shimotoriharuki/2019_RobotLancer_kicad/General_purpose_lancer_board/PIC/pcb.png

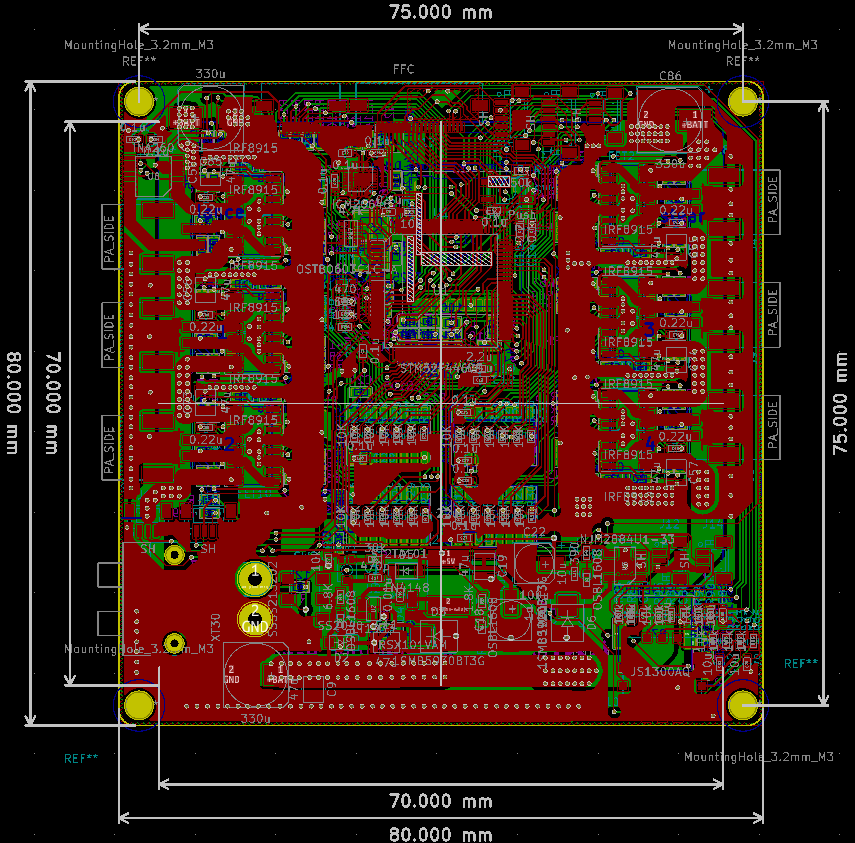
General_purpose_lancer_board/PIC/pcb.png
