shimotoriharuki/2019_RobotLancer_kicad/General_purpose_lancer_board_sub/PIC/top.png

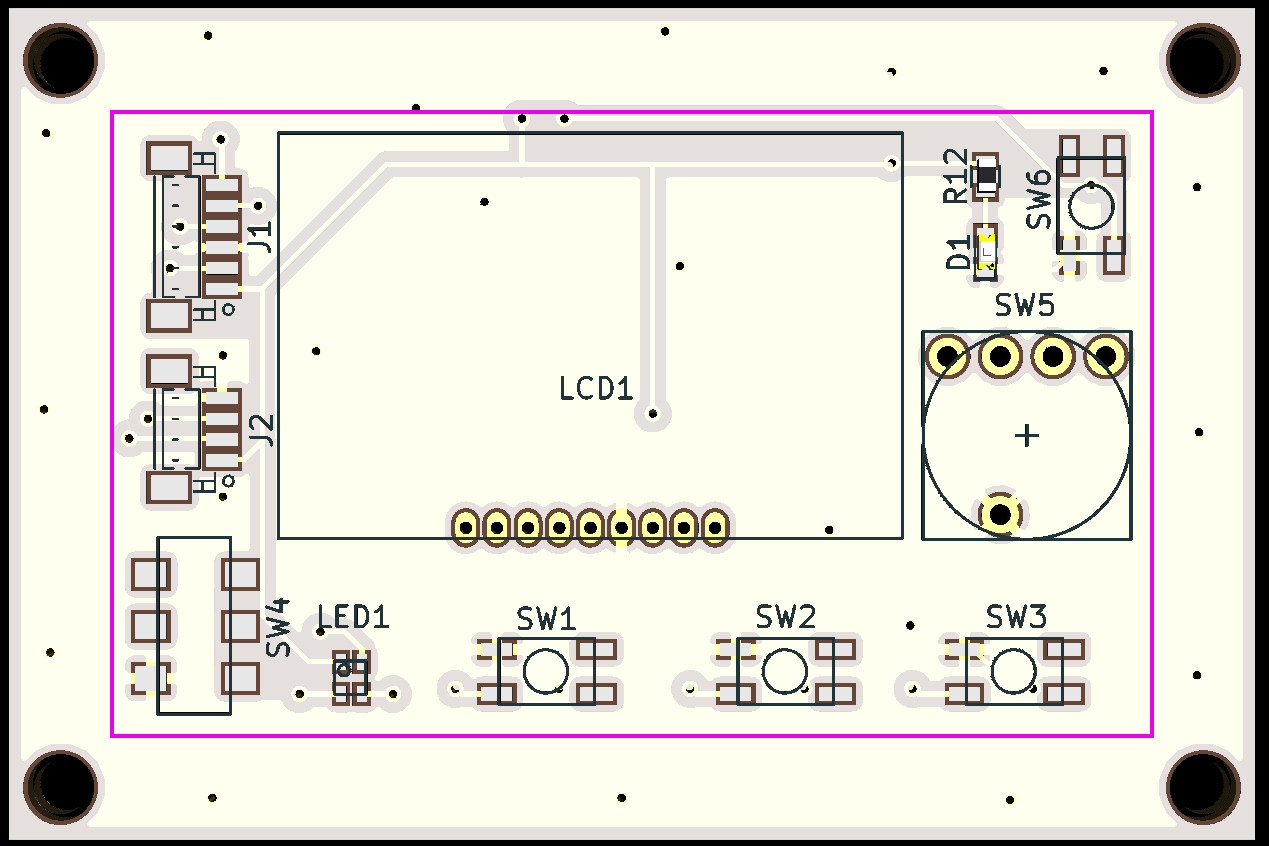
General_purpose_lancer_board_sub/PIC/top.png
