shimotoriharuki/2019_RobotLancer_kicad/General_purpose_lancer_sensor_board/PIC/top.png

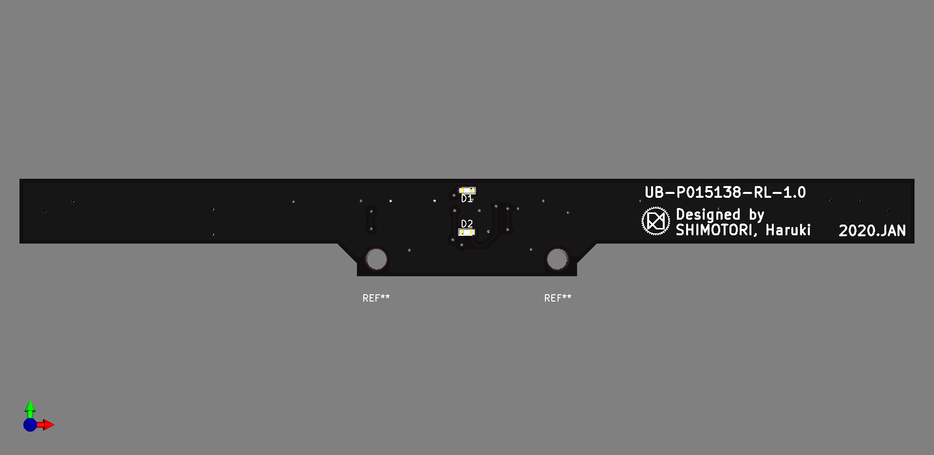
General_purpose_lancer_sensor_board/PIC/top.png
