shimotoriharuki/2019_RobotLancer_kicad/General_purpose_lancer_sensor_board/PIC/コメント 2020-01-31 151015.png

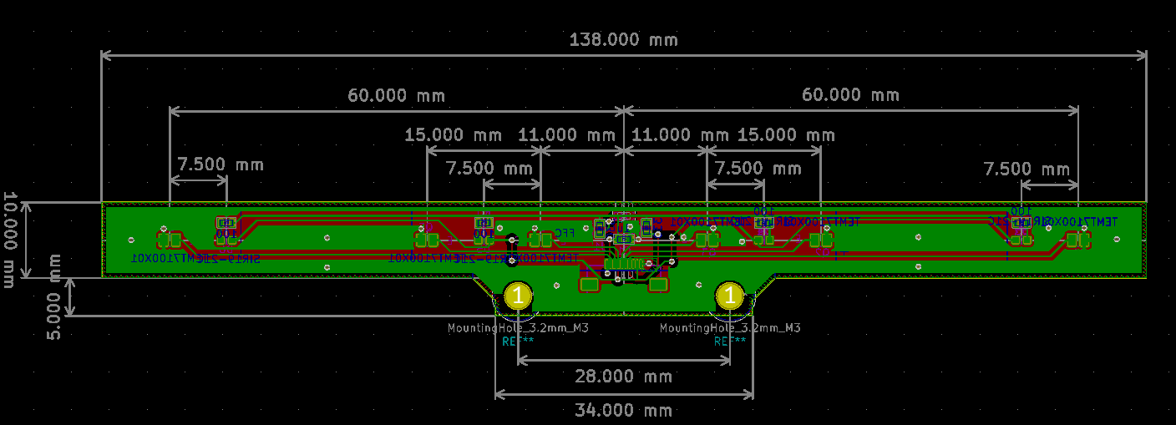
General_purpose_lancer_sensor_board/PIC/コメント 2020-01-31 151015.png
