shimotoriharuki/2019_RobotLancer_kicad/General_purpose_lancer_sensor_board/ref/コメント 2020-01-18 161346.png

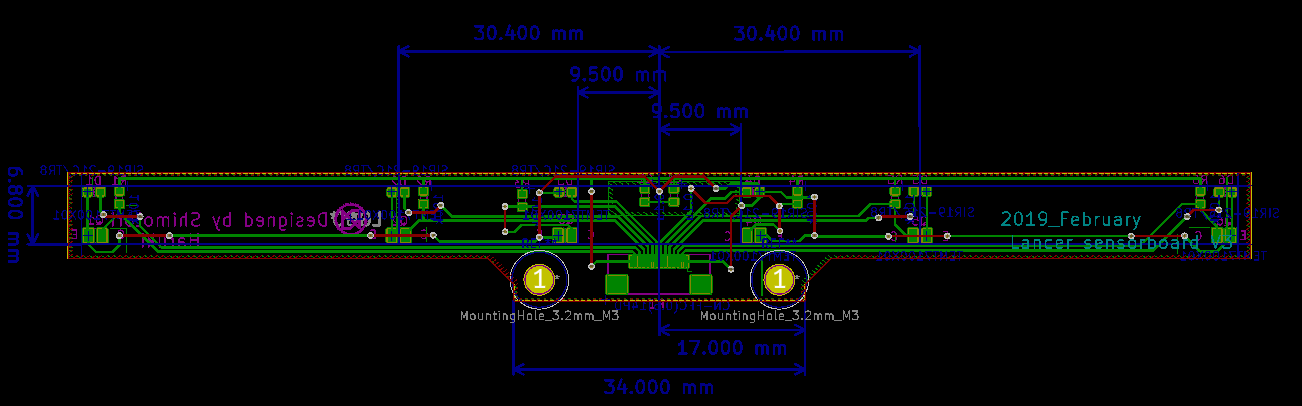
General_purpose_lancer_sensor_board/ref/コメント 2020-01-18 161346.png
