shimotoriharuki/2019_RobotLancer_kicad/General_purpose_lancer_board/General_purpose_lancer_board.xlsx

Library | Part | Footprint | Value | Number | Reference
Connector | Micro_SD_Card_Det_Hirose_DM3AT | Connectors_Card:Hirose_DM3AT-SF-PEJM5 | Micro_SD_Card_Det_Hirose_DM3AT | 1 | J13
Connector_Generic | Conn_01x02 | Footprint:SM02B-PASS | PA_SIDE | 6 | J9, J8, J5, J7, J4, J6
Connector_Generic | Conn_01x02 | Footprint:XT30PW-M | XT30 | 1 | J3
Connector_Generic | Conn_01x03 | Connectors_JST:JST_SH_BM03B-SRSS-TB_03x1.00mm_Straight | SH | 3 | J11, J12, J14
Connector_Generic | Conn_01x04 | Connectors_JST:JST_SH_BM04B-SRSS-TB_04x1.00mm_Straight | SH | 2 | J10, J2
Connector_Generic | Conn_01x05 | Connectors_JST:JST_SH_BM05B-SRSS-TB_05x1.00mm_Straight | SH | 1 | J15
Connector_Generic | Conn_01x06 | Connectors_JST:JST_SH_BM06B-SRSS-TB_06x1.00mm_Straight | SH | 1 | J1
Connector_Generic | Conn_01x10 | Footprint:Molex_FFC_10 | FFC | 1 | J16
Connector_Generic | Conn_01x22 | Footprint:Molex_FFC_22 | FFC | 1 | J17
Device | Buzzer | Buzzers_Beepers:Buzzer_Murata_PKMCS0909E4000-R1 | PKMCS0909E4000-R1 | 1 | BZ1
Device | C | Capacitors_SMD:C_0603 | 10u | 1 | C84
Device | C | Capacitors_SMD:C_1210 | 47u | 6 | C56, C73, C74, C58, C55, C57
Device | CP | Capacitors_SMD:CP_Elec_8x6.7 | 330u | 2 | C85, C86
Device | CP | Capacitors_SMD:C_1210 | 47u | 1 | C83
Device | CP_Small | Capacitors_SMD:CP_Elec_5x5.8 | 100u | 2 | C22, C18
Device | CP_Small | Capacitors_SMD:CP_Elec_8x6.7 | 330u | 1 | C8
Device | C_Small | Capacitors_SMD:C_0603 | 0.01u | 1 | C16
Device | C_Small | Capacitors_SMD:C_0603 | 0.1u | 34 | C1, C26, C30, C12, C15, C25, C29, C24, C28, C77, C3, C6, C2, C82, C76, C31, C5, C59, C81, C78, C64, C7, C13, C60, C80, C63, C32, C33, C4, C23, C79, C75, C27, C37
Device | C_Small | Capacitors_SMD:C_0603 | 0.22u | 18 | C69, C41, C50, C65, C49, C39, C46, C47, C40, C44, C66, C72, C43, C71, C51, C54, C53, C68
Device | C_Small | Capacitors_SMD:C_0603 | 0.47u | 6 | C38, C36, C62, C35, C61, C34
Device | C_Small | Capacitors_SMD:C_0603 | 10u | 7 | C52, C48, C70, C21, C67, C45, C42
Device | C_Small | Capacitors_SMD:C_0603 | 1u | 1 | C20
Device | C_Small | Capacitors_SMD:C_0603 | 2.2u | 2 | C10, C14
Device | C_Small | Capacitors_SMD:C_0603 | 470p | 1 | C17
Device | C_Small | Capacitors_SMD:C_1210 | 47u | 3 | C9, C19, C11
Device | D_Schottky_Small_ALT | Diodes_SMD:D_SOD-123 | 1N4148 | 1 | D5
Device | D_Schottky_Small_ALT | Diodes_SMD:D_SOD-123F | SS2040 | 1 | D2
Device | D_Schottky_Small_ALT | Footprint:TUMD2M | RSX101VAM | 1 | D4
Device | D_Zener_Small_ALT | Diodes_SMD:D_SMB | 1SMB5920BT3G | 1 | D6
Device | D_Zener_Small_ALT | Diodes_SMD:D_SMB | 1SMB5930BT3G | 1 | D3
Device | Ferrite_Bead_Small | Inductors_SMD:L_0603 | 120 | 6 | L8, L7, L6, L5, L4, L3
Device | Ferrite_Bead_Small | Inductors_SMD:L_0603 | 330 | 1 | L1
Device | LED_Small_ALT | LEDs:LED_0603 | OSBL1608 | 3 | D7, D8, D1
Device | L_Small | Footprint:SD25-220-R | 22u | 1 | SD25-220-R1
Device | Q_NMOS_GSD | TO_SOT_Packages_SMD:SOT-23 | BSS138 | 1 | Q3
Device | Q_NMOS_GSD | TO_SOT_Packages_SMD:SOT-23 | IRLML6344 | 1 | Q2
Device | R | Resistors_SMD:R_0603 | 0 | 1 | R97
Device | R | Resistors_SMD:R_0603 | 1.2k | 1 | R84
Device | R | Resistors_SMD:R_0603 | 10K | 42 | R28, R35, R36, R39, R47, R42, R67, R69, R71, R46, R70, R30, R26, R22, R18, R14, R66, R10, R38, R33, R29, R25, R34, R37, R40, R21, R17, R11, R15, R41, R23, R27, R31, R13, R48, R32, R12, R16, R20, R24, R68, R19
Device | R | Resistors_SMD:R_0603 | 10k | 14 | R87, R88, R93, R96, R92, R99, R98, R90, R95, R91, R89, R94, R3, R107
Device | R | Resistors_SMD:R_0603 | 12k | 1 | R2
Device | R | Resistors_SMD:R_0603 | 15K | 1 | R5
Device | R | Resistors_SMD:R_0603 | 1k | 1 | R108
Device | R | Resistors_SMD:R_0603 | 22k | 7 | R106, R105, R101, R103, R104, R102, R100
Device | R | Resistors_SMD:R_0603 | 4.7k | 2 | R83, R74
Device | R | Resistors_SMD:R_0603 | 45 | 2 | R111, R117
Device | R | Resistors_SMD:R_0603 | 470 | 1 | R86
Device | R | Resistors_SMD:R_0603 | 47k | 1 | R114
Device | R | Resistors_SMD:R_0603 | 50k | 1 | R1
Device | R | Resistors_SMD:R_0603 | 680 | 1 | R85
Device | R | Resistors_SMD:R_0603 | R | 6 | R110, R116, R115, R112, R113, R109
Device | R_POT | Footprint:ST2TA | ST2TA101 | 1 | RV1
Device | R_Pack04 | Resistors_SMD:R_Array_Convex_4x0603 | 10K | 6 | RN2, RN3, RN1, RN6, RN4, RN5
Device | R_Pack04 | Resistors_SMD:R_Array_Convex_4x0603 | 4.7k | 1 | RN7
Device | R_Small | Resistors_SMD:R_0603 | 1.8K | 1 | R8
Device | R_Small | Resistors_SMD:R_0603 | 10k | 1 | R7
Device | R_Small | Resistors_SMD:R_0603 | 30k | 1 | R6
Device | R_Small | Resistors_SMD:R_0603 | 390 | 1 | R9
Device | R_Small | Resistors_SMD:R_0603 | 5k | 6 | R44, R73, R45, R49, R72, R43
Device | R_Small | Resistors_SMD:R_0603 | 6.8K | 1 | R4
Device | R_Small | Resistors_SMD:R_0603 | 75 | 24 | R63, R64, R65, R56, R57, R75, R58, R59, R60, R50, R51, R52, R53, R61, R80, R81, R82, R76, R77, R78, R79, R54, R55, R62
Oscillator | ASE-xxxMHz | Crystals:Crystal_SMD_EuroQuartz_X22-4pin_2.5x2.0mm_HandSoldering | ECS-2520S | 1 | X1
Oscillator | ASE-xxxMHz | Crystals:Crystal_SMD_EuroQuartz_X22-4pin_2.5x2.0mm_HandSoldering | TC25L5I32K7680 | 1 | X2
Switch | SW_Push | Footprint:SKRPACE010 | SKRPACE010 | 1 | SW1
Switch | SW_SPDT | Footprint:SSSS213202 | SSSS213202 | 1 | SW2
shimoharu_library | A3921 | Housings_SSOP:TSSOP-28-1EP_4.4x9.7mm_Pitch0.65mm | A3921 | 6 | IC5, IC1, IC2, IC4, IC3, IC6
shimoharu_library | ICM20648 | Footprint:ICM20648 | ICM20648 | 1 | U9
shimoharu_library | INA260 | Housings_SSOP:TSSOP-16_4.4x5mm_Pitch0.65mm | INA260 | 1 | U8
shimoharu_library | IRF8915 | Footprint:IRF8915 | IRF8915 | 12 | FET9, FET2, FET5, FET1, FET8, FET7, FET12, FET4, FET3, FET11, FET10, FET6
shimoharu_library | JS1300AQ | Footprint:JS1300 | JS1300AQ | 1 | U10
shimoharu_library | LT1933 | TO_SOT_Packages_SMD:TSOT-23-6 | LT1933 | 1 | U2
shimoharu_library | NJM2884U1-33 | TO_SOT_Packages_SMD:SOT-89-5_Housing | NJM2884U1-33 | 1 | U3
shimoharu_library | OSTB0603C1C-A | Footprint:OSTB0603C1C-A | OSTB0603C1C-A | 1 | LED1
shimoharu_library | SI8660BA | Housings_SOIC:SOIC-16_3.9x9.9mm_Pitch1.27mm | SI8660BA | 4 | U4, U5, U6, U7
shimoharu_library | STM32F446VE | Housings_QFP:LQFP-100_14x14mm_Pitch0.5mm | STM32F446VE | 1 | U1
shimoharu_library | uPA2815T1S | Footprint:SO-8_PowerPAK_Vishay_Single | SI7141DP | 1 | FET13
