shimotoriharuki/2019_RobotLancer_kicad/General_purpose_lancer_board_sub/General_purpose_lancer_board_sub.xlsx

Library | Part | Footprint | Value | Number | Reference
Connector_Generic | Conn_01x04 | Connectors_JST:JST_SH_BM04B-SRSS-TB_04x1.00mm_Straight | SH | 1 | J2
Connector_Generic | Conn_01x06 | Connectors_JST:JST_SH_BM06B-SRSS-TB_06x1.00mm_Straight | SH | 1 | J1
Connector_Generic | Conn_01x22 | Footprint:Molex_FFC_22 | FFC | 1 | J3
Device | C | Capacitors_SMD:C_0603 | 0.1u | 1 | C8
Device | CP | Capacitors_SMD:CP_Elec_5x5.8 | 82u | 1 | C9
Device | C_Small | Capacitors_SMD:C_0603 | 0.1u | 5 | C3, C7, C4, C2, C1
Device | C_Small | Capacitors_SMD:C_0603 | 1u | 2 | C5, C6
Device | LED | LEDs:LED_0603 | OSBL1608C1A | 1 | D1
Device | R | Resistors_SMD:R_0603 | 1.2k | 1 | R7
Device | R | Resistors_SMD:R_0603 | 10k | 6 | R4, R3, R1, R5, R2, R6
Device | R | Resistors_SMD:R_0603 | 360 | 1 | R12
Device | R | Resistors_SMD:R_0603 | 4.7k | 2 | R11, R10
Device | R | Resistors_SMD:R_0603 | 470 | 1 | R9
Device | R | Resistors_SMD:R_0603 | 680 | 1 | R8
Switch | SW_Coded_SH-7050 | Footprint:FR01SC16P | FR01SC16P-S | 1 | SW5
Switch | SW_Push | Footprint:SKRPACE010 | SKRPACE010 | 4 | SW3, SW2, SW6, SW1
Switch | SW_SPDT | Footprint:SSSS213202 | SSSS213202 | 1 | SW4
lancer_subbord-rescue | AQM0802A | Footprint:AQM0802A | AQM0802A | 1 | LCD1
shimoharu_library | OSTB0603C1C-A | Footprint:OSTB0603C1C-A | OSTB0603C1C-A | 1 | LED1
