shimotoriharuki/2019_RobotLancer_kicad/General_purpose_lancer_sensor_board/General_purpose_lancer_sensor_board.xlsx

Library | Part | Footprint | Value | Number | Reference
Connector_Generic | Conn_01x10 | Footprint:Molex_FFC_10 | FFC | 1 | J1
Device | C | Capacitors_SMD:C_0603 | 1u | 1 | C1
Device | LED | Footprint:SIR19-21C | SIR19-21C | 4 | D4, D3, D5, D6
Device | LED | LEDs:LED_0603 | OSBL1608C1A | 2 | D1, D2
Device | Q_Photo_NPN | Footprint:TEMT7100X01 | TEMT7100X01 | 6 | Q4, Q2, Q1, Q6, Q5, Q3
Device | R | Resistors_SMD:R_0603 | 100 | 4 | R4, R3, R5, R6
Device | R | Resistors_SMD:R_0603 | 330 | 2 | R1, R2
