shimotoriharuki/2019_RobotLancer_kicad/DXF/main_board_edge_8080.dxf

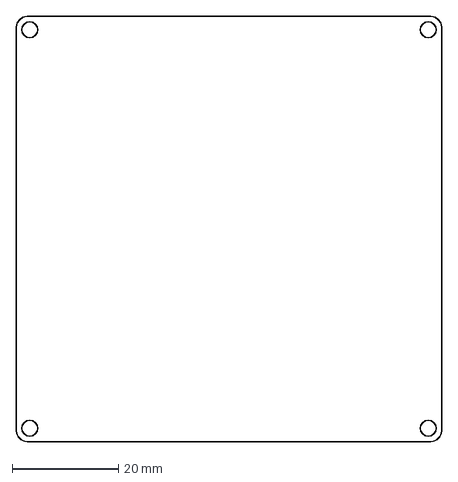
[picture p12: CAD file, 2021-03-22]
DXF/main_board_edge_8080.dxf
80.0 x 80.0 mm
