shimotoriharuki/2019_RobotLancer_kicad/DXF/main_board_edge.dxf

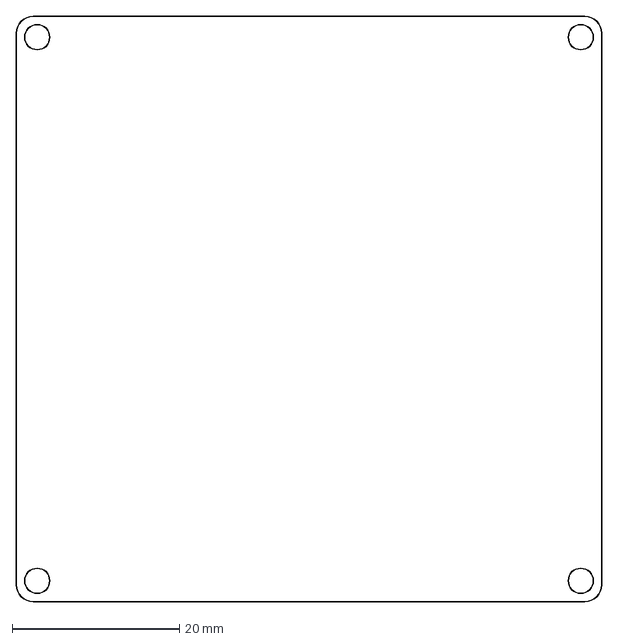
[picture p13: CAD file, 2021-03-22]
DXF/main_board_edge.dxf
70.0 x 70.0 mm
