shimotoriharuki/2019_RobotLancer_kicad/DXF/up plate.dxf

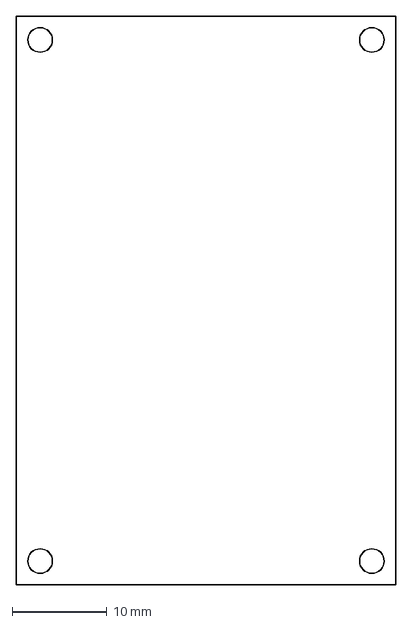
[picture p14: CAD file, 2021-03-22]
DXF/up plate.dxf
40.0 x 60.0 mm
