shimotoriharuki/2019_RobotLancer_kicad/General_purpose_lancer_board_sub/STEP/General_purpose_lancer_board_sub.step

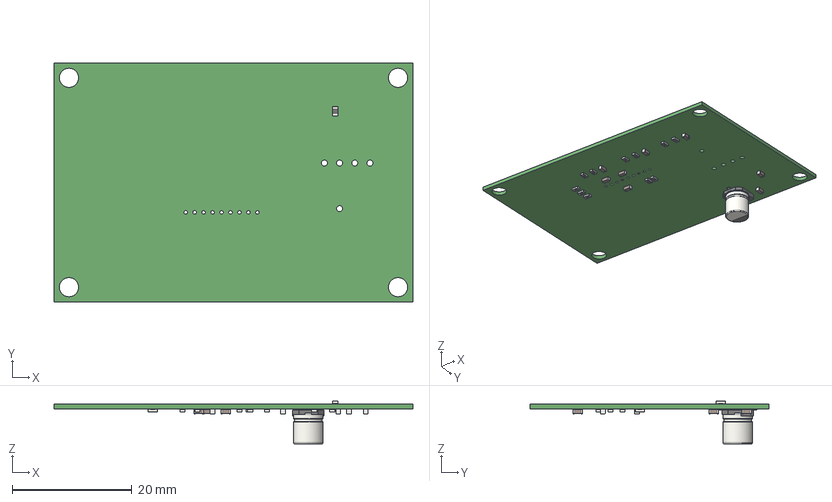
[picture p15: CAD file, 2021-03-22]
General_purpose_lancer_board_sub/STEP/General_purpose_lancer_board_sub.step
60.0 x 40.0 x 7.15 mm
LED_0603
