shimotoriharuki/2019_RobotLancer_kicad/General_purpose_lancer_sensor_board/STEP/General_purpose_lancer_sensor_board.step

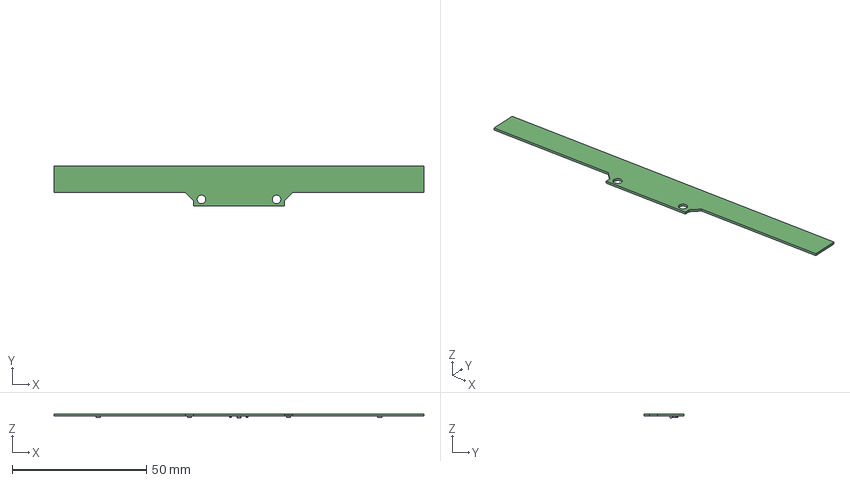
[picture p16: CAD file, 2021-03-22]
General_purpose_lancer_sensor_board/STEP/General_purpose_lancer_sensor_board.step
138.0 x 15.0 x 1.63 mm
LED_0603 x 2
