shimotoriharuki/2019_RobotLancer_kicad/(list of files, cad)

Other CAD files:
DXF/sensor.dxf
General_purpose_lancer_board/STEP/COMPOUND.ipt
General_purpose_lancer_board/STEP/CP_Elec_5x5.8.iam
General_purpose_lancer_board/STEP/CP_Elec_8x6.7.iam
General_purpose_lancer_board/STEP/C_0603.iam
General_purpose_lancer_board/STEP/C_1210.iam
General_purpose_lancer_board/STEP/D_SMB.iam
General_purpose_lancer_board/STEP/D_SOD-123.iam
General_purpose_lancer_board/STEP/D_SOD-123F.iam
General_purpose_lancer_board/STEP/General_purpose_lancer_board.iam
General_purpose_lancer_board/STEP/LQFP-100_14x14mm_Pitch0.5mm.iam
General_purpose_lancer_board/STEP/L_0603.iam
General_purpose_lancer_board/STEP/R_0603.iam
General_purpose_lancer_board/STEP/R_Array_Convex_4x0603.iam
General_purpose_lancer_board/STEP/SOIC-16_3.9x9.9mm_Pitch1.27mm.iam
General_purpose_lancer_board/STEP/SOLID.ipt
General_purpose_lancer_board/STEP/SOLID_1.ipt
General_purpose_lancer_board/STEP/SOLID_10.ipt
General_purpose_lancer_board/STEP/SOLID_11.ipt
General_purpose_lancer_board/STEP/SOLID_12.ipt
General_purpose_lancer_board/STEP/SOLID_13.ipt
General_purpose_lancer_board/STEP/SOLID_14.ipt
General_purpose_lancer_board/STEP/SOLID_2.ipt
General_purpose_lancer_board/STEP/SOLID_3.ipt
General_purpose_lancer_board/STEP/SOLID_4.ipt
General_purpose_lancer_board/STEP/SOLID_5.ipt
General_purpose_lancer_board/STEP/SOLID_6.ipt
General_purpose_lancer_board/STEP/SOLID_7.ipt
General_purpose_lancer_board/STEP/SOLID_8.ipt
General_purpose_lancer_board/STEP/SOLID_9.ipt
General_purpose_lancer_board/STEP/SOT-23.iam
General_purpose_lancer_board/STEP/TSSOP-16_4.4x5mm_Pitch0.65mm.iam
General_purpose_lancer_board/STEP/TSSOP-28_4.4x9.7mm_Pitch0.65mm.iam
General_purpose_lancer_board_sub/STEP/COMPOUND.ipt
General_purpose_lancer_board_sub/STEP/CP_Elec_5x5.8.iam
General_purpose_lancer_board_sub/STEP/C_0603.iam
General_purpose_lancer_board_sub/STEP/General_purpose_lancer_board_sub.iam
General_purpose_lancer_board_sub/STEP/R_0603.iam
General_purpose_lancer_board_sub/STEP/SOLID.ipt
General_purpose_lancer_board_sub/STEP/SOLID_1.ipt
General_purpose_lancer_board_sub/STEP/SOLID_2.ipt
