shimotoriharuki/2019_RobotLancer_kicad/General_purpose_lancer_board/PDF/General_purpose_lancer_board.pdf

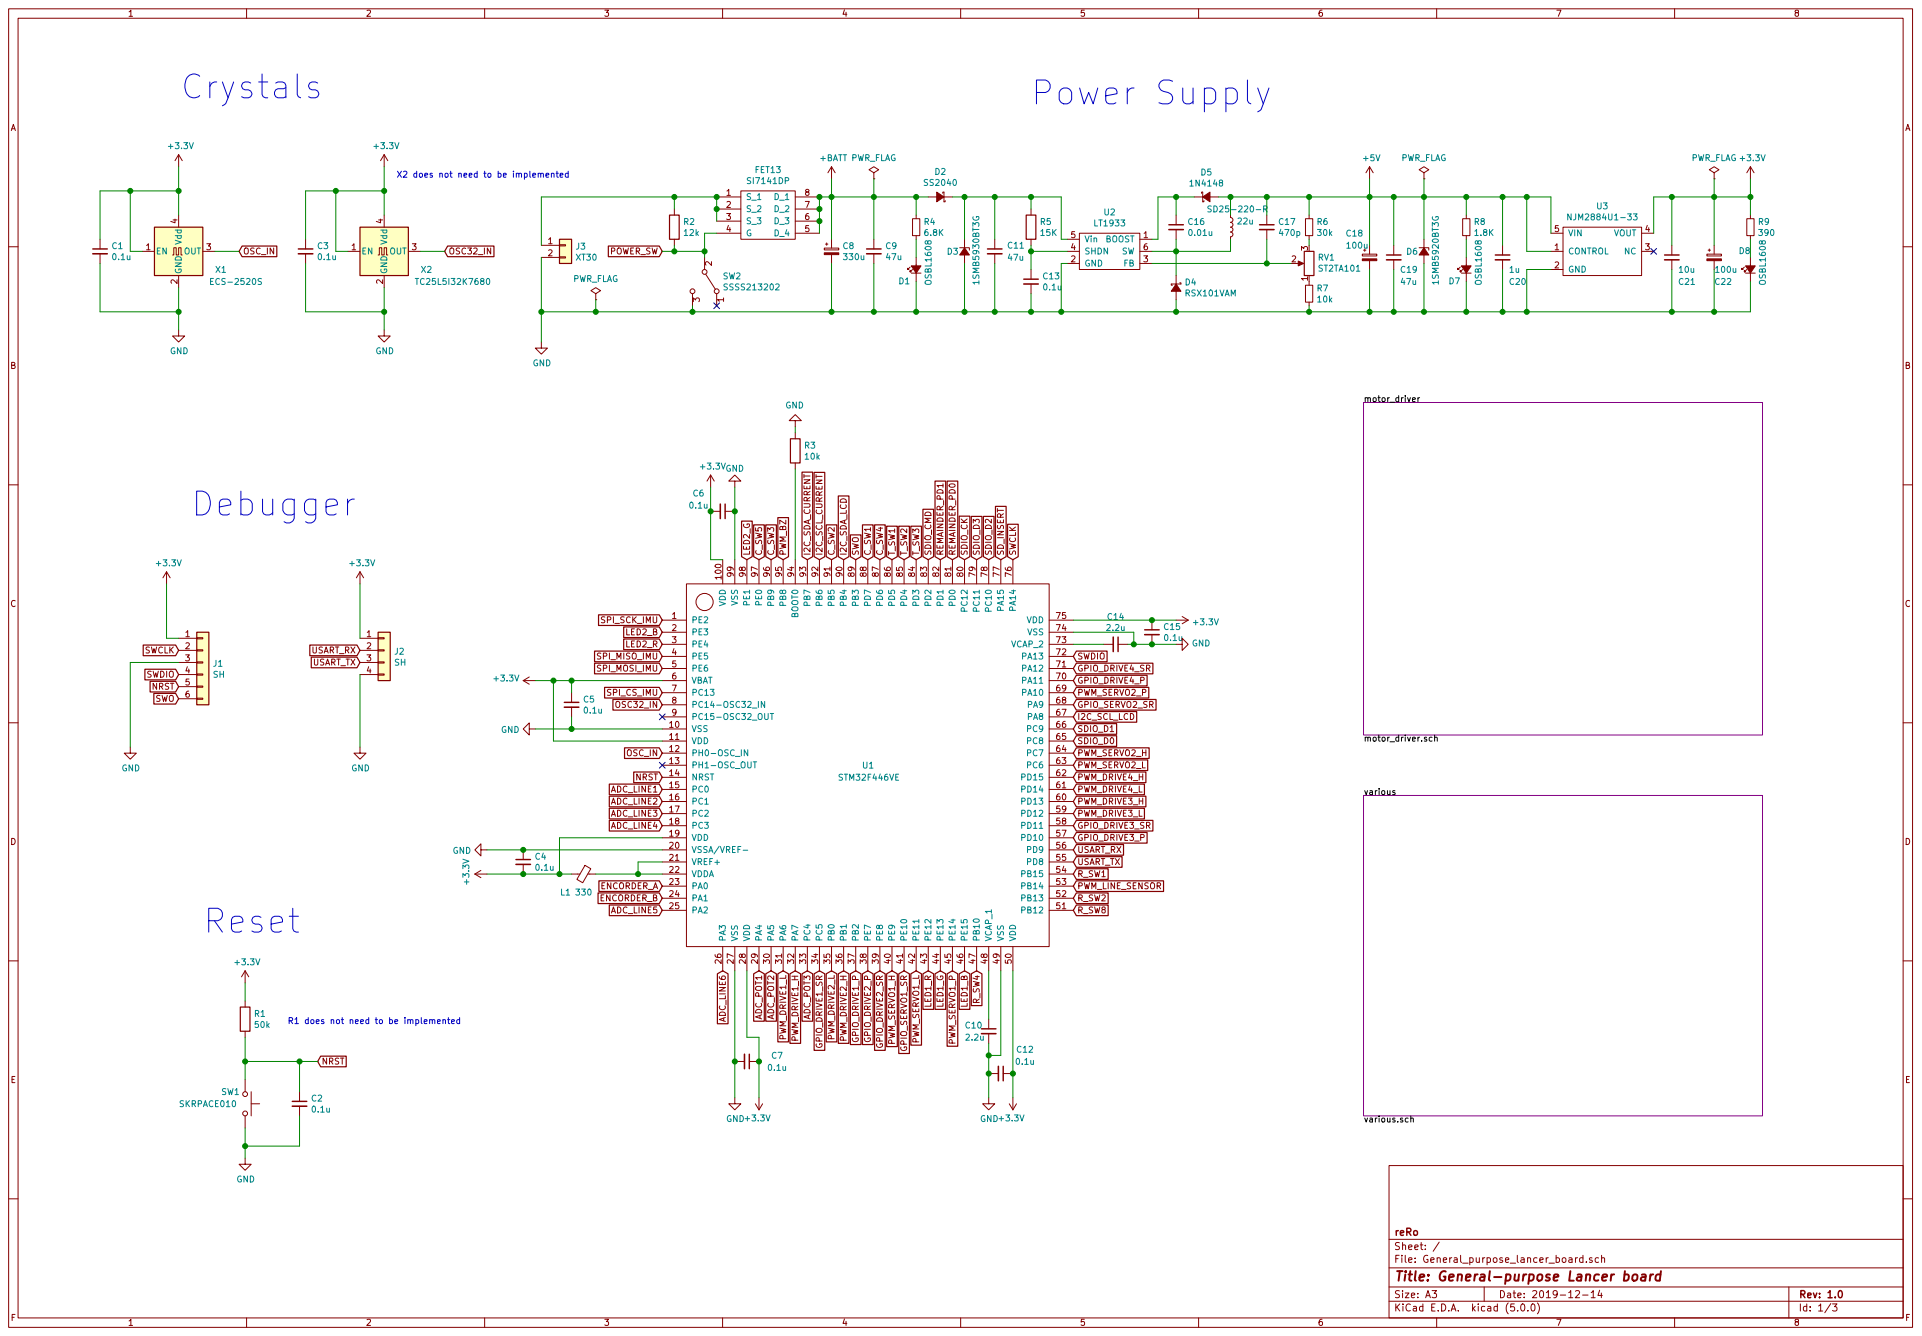
[picture p17: page 1]

X2 does not need to be implemented

R1 does not need to be implemented

File: General_purpose_lancer_board.sch Sheet: / reRo

Id: 1/3 Title: General-purpose Lancer board

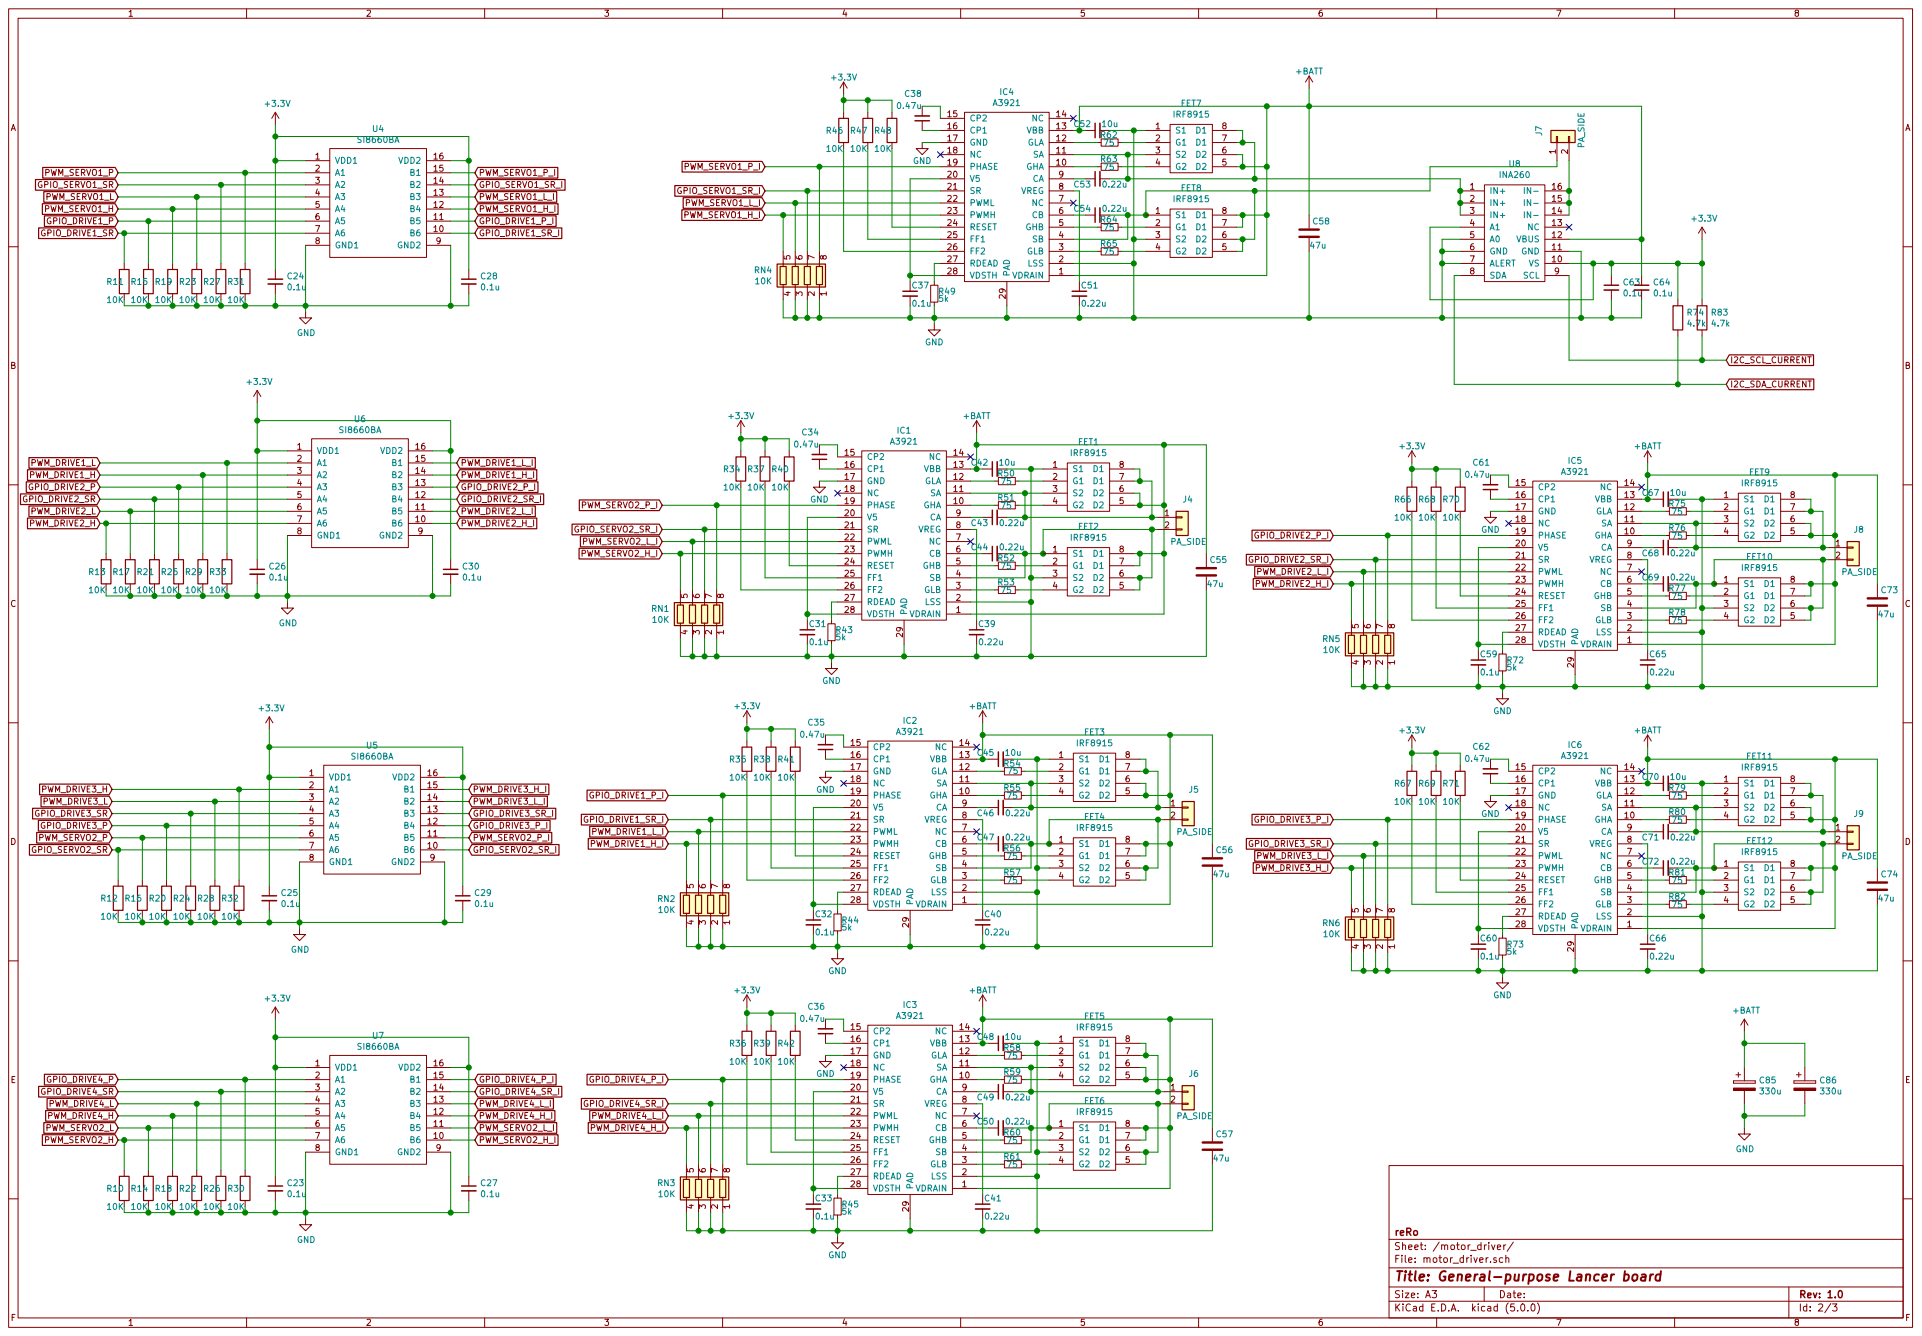
[picture p18: page 2]

File: motor_driver.sch
Id: 2/3 Title: General-purpose Lancer board

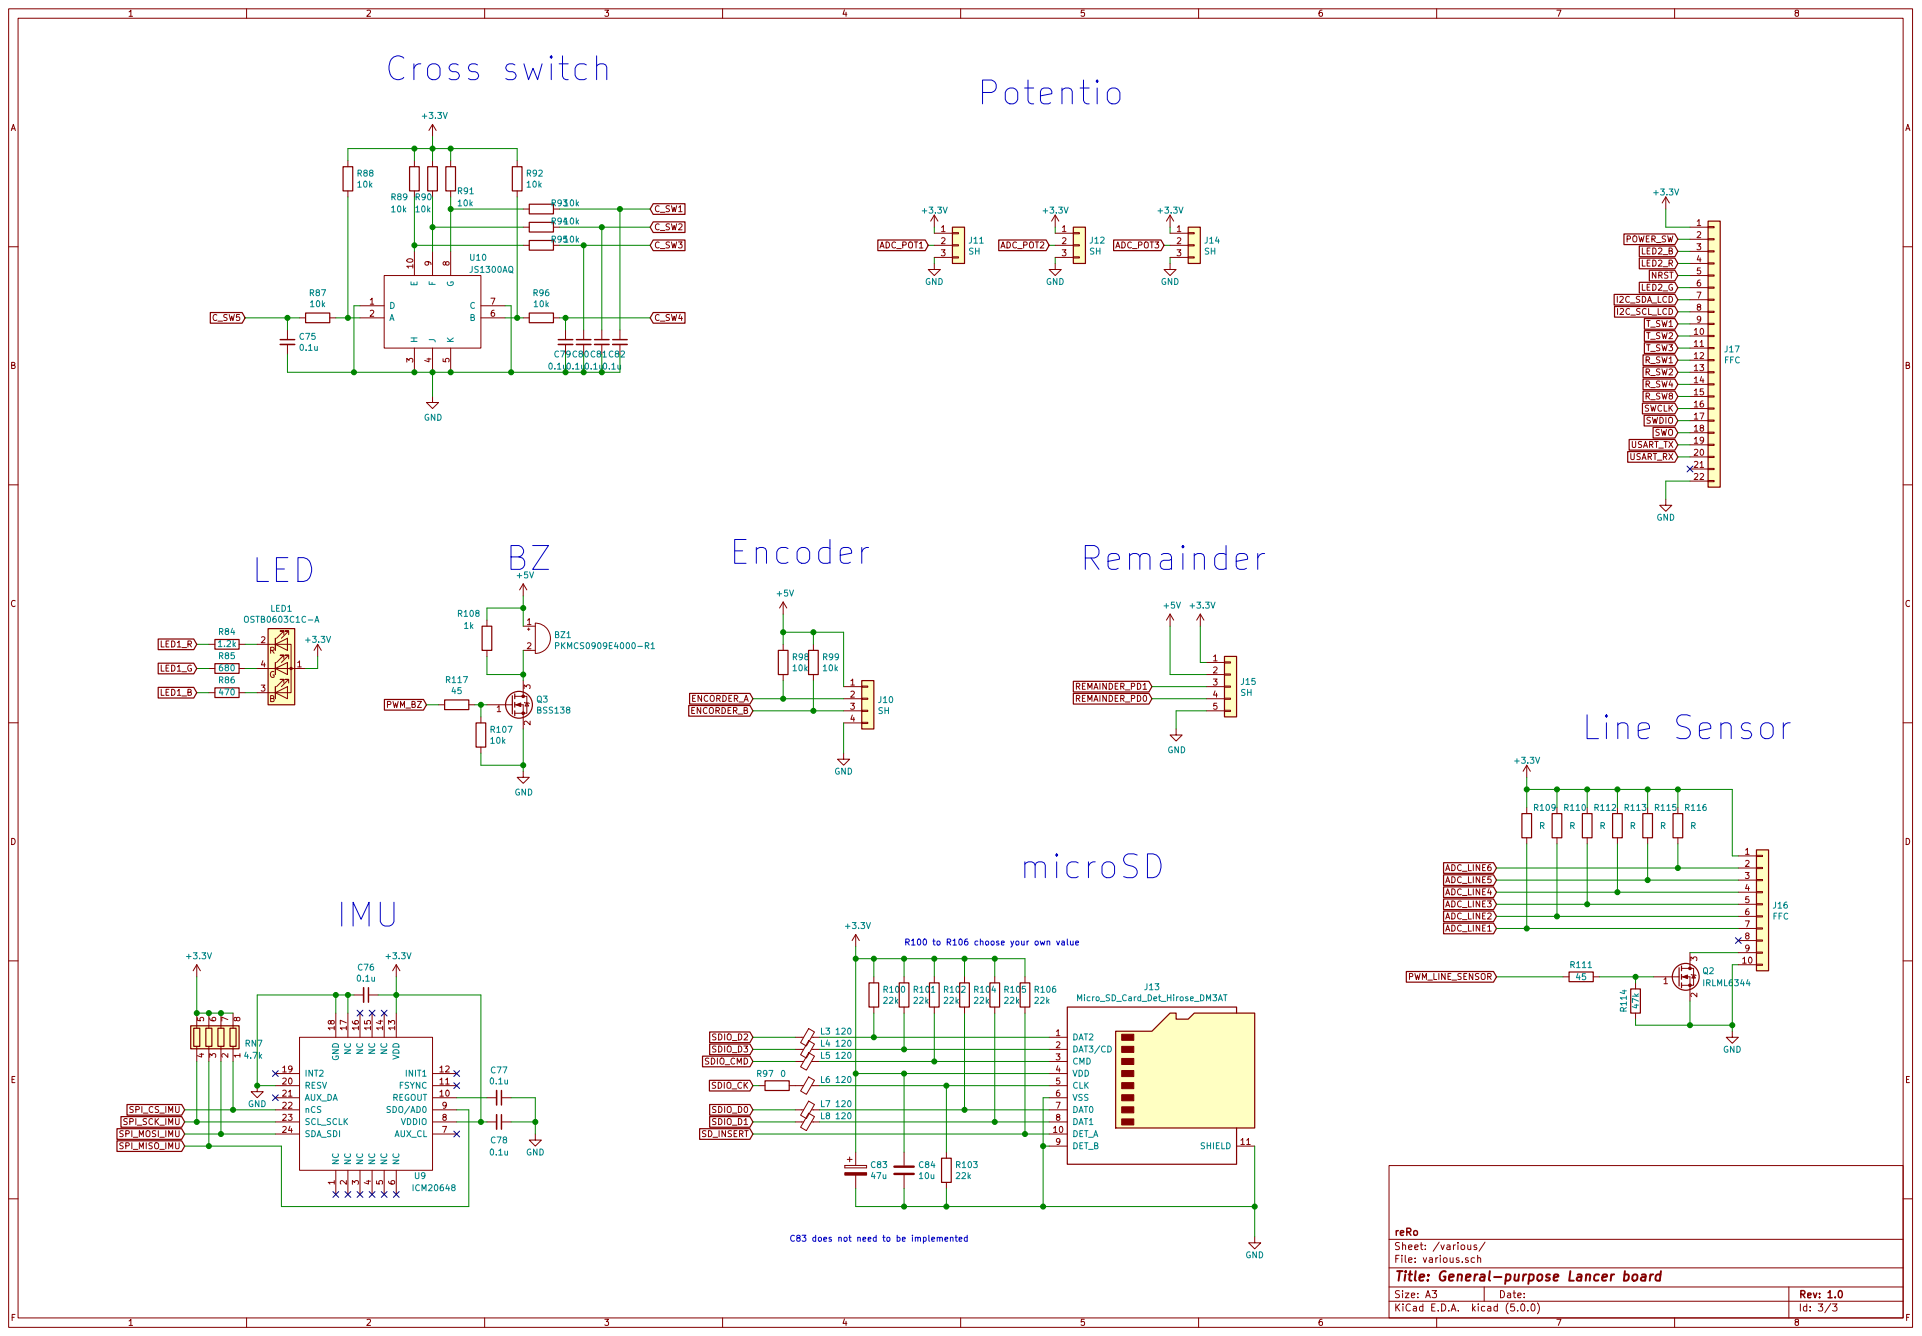
[picture p19: page 3]

File: various.sch Sheet: /various/ reRo GND microSD

R100 to R106 choose your own value

C83 does not need to be implemented

Id: 3/3 Title: General-purpose Lancer board
