shimotoriharuki/2019_RobotLancer_kicad/General_purpose_lancer_board_sub/PDF/General_purpose_lancer_board_sub.pdf

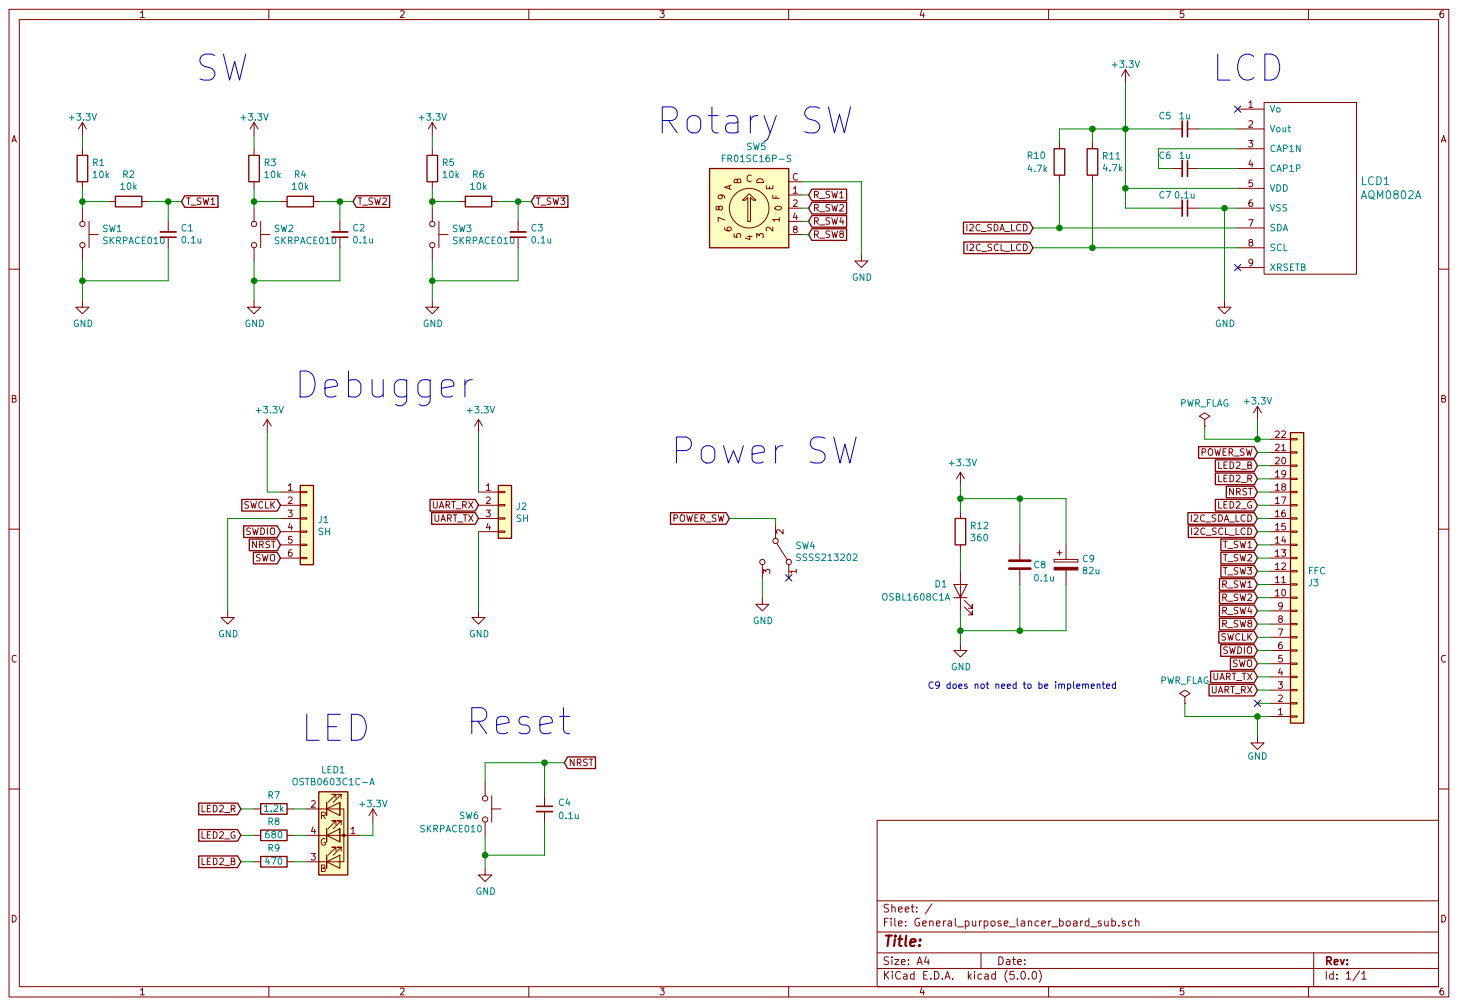
[picture p20: page 1]

C9 does not need to be implemented
