shimotoriharuki/2019_RobotLancer_kicad/General_purpose_lancer_sensor_board/PDF/General_purpose_lancer_sensor_board.pdf

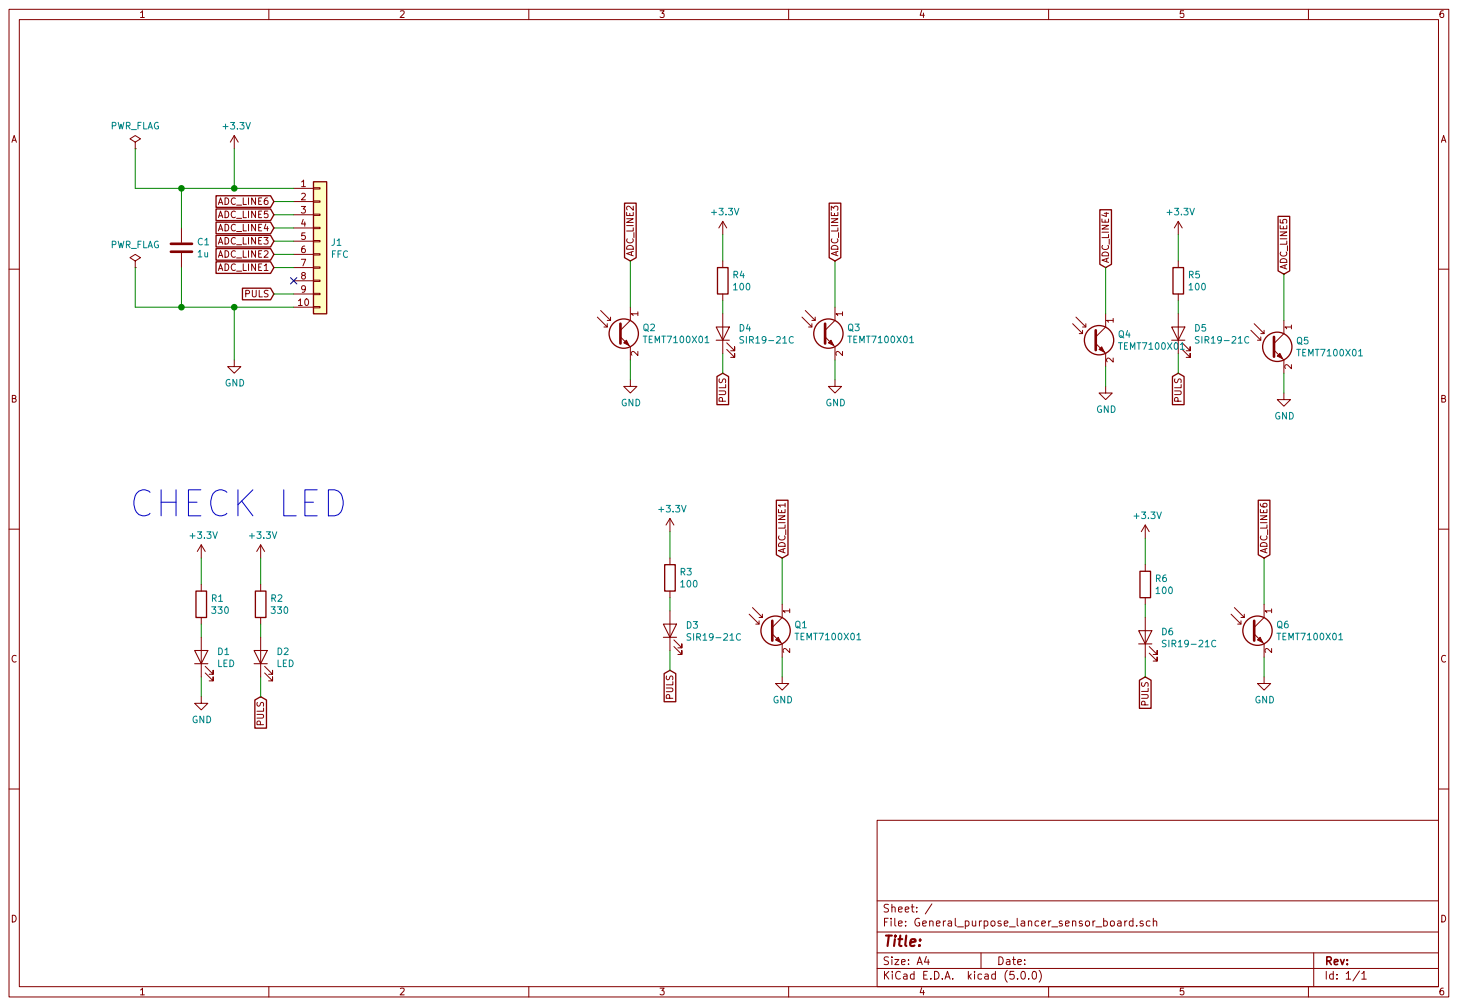
[picture p21: page 1]
