shimotoriharuki/2019_RobotLancer_kicad/General_purpose_lancer_sensor_board/General_purpose_lancer_sensor_board/PDF/General_purpose_lancer_sensor_board.pdf

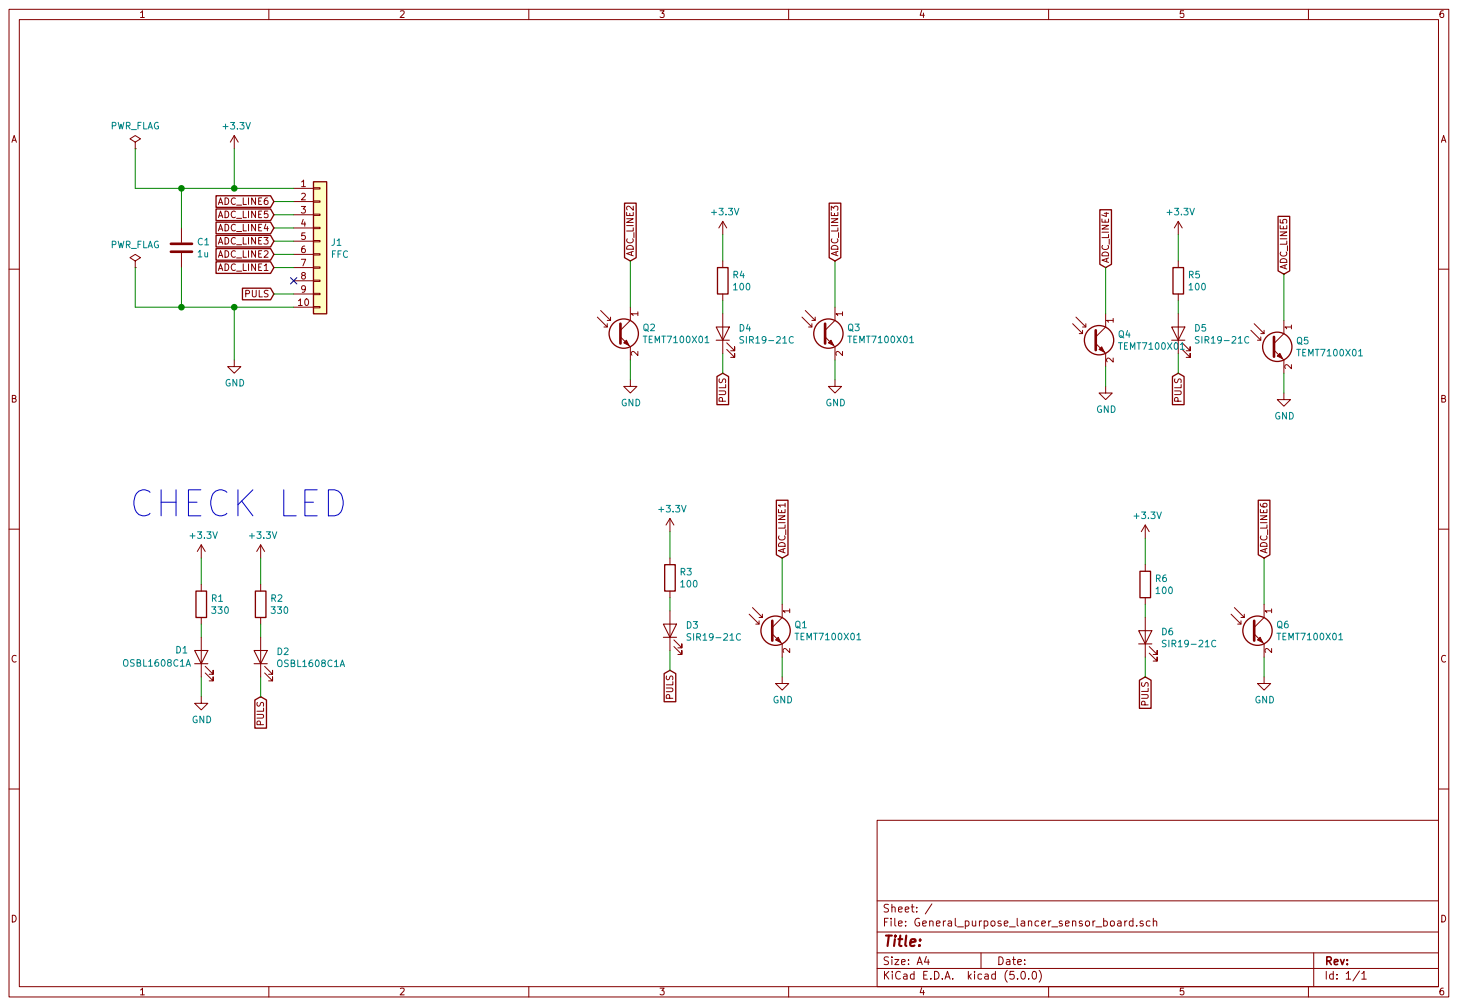
[picture p22: page 1]
