shimotoriharuki/2019_RobotLancer_kicad/General_purpose_lancer_board_sub/General_purpose_lancer_board_sub.kicad_pcb

## KiCad design General_purpose_lancer_board_sub/General_purpose_lancer_board_sub.kicad_pcb (2021-03-22)

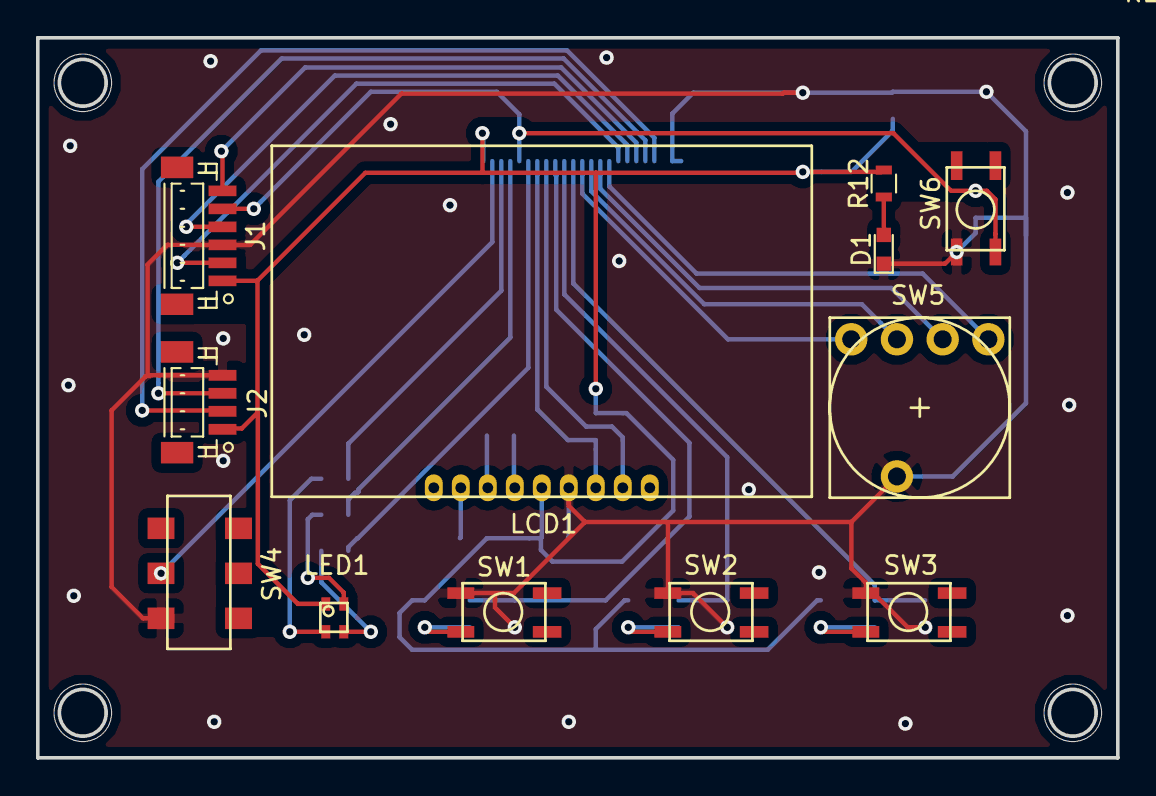
[picture p23: board General_purpose_lancer_board_sub.kicad_pcb from above]

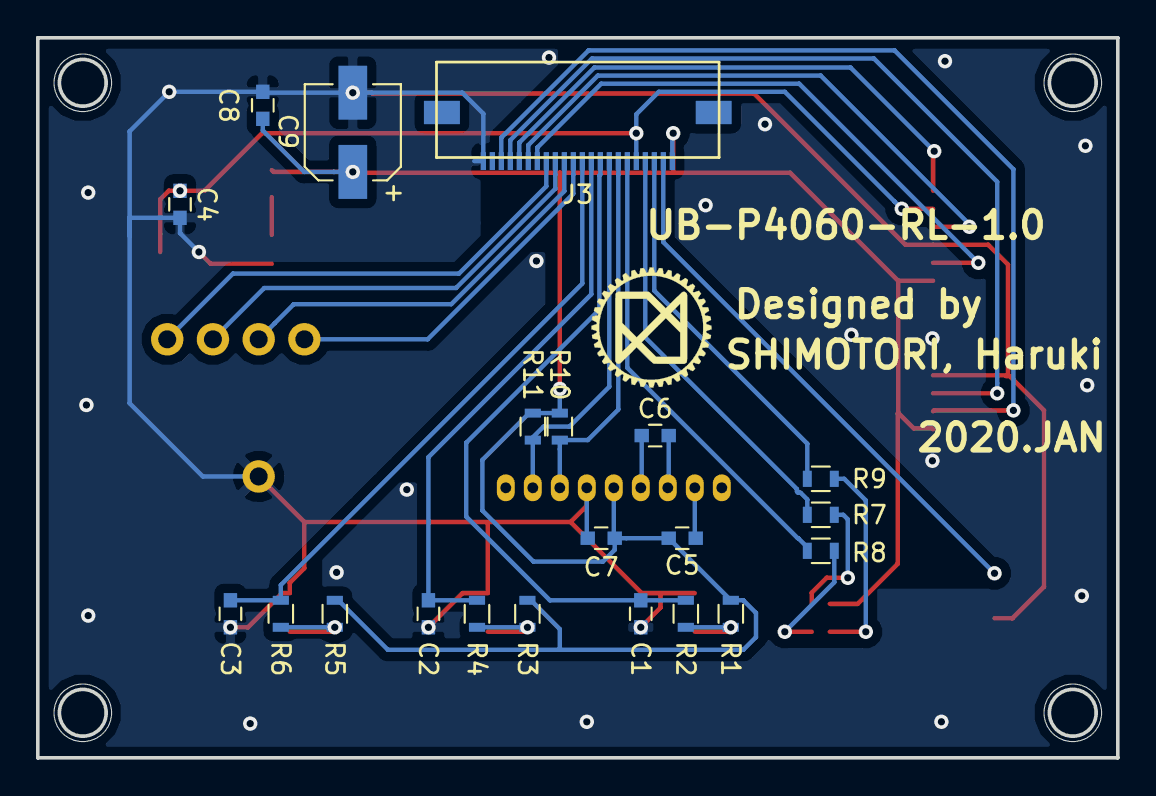
[picture p24: board General_purpose_lancer_board_sub.kicad_pcb from below]

Board: 2 copper layers, 60.0 x 40.0 mm, 33 parts (21 on the bottom side), 31 nets.

Parts:
C1, C2, C3, C4, C7: 0.1u; C_0603
C5, C6: 1u; C_0603
C8: 0.1; C_0603
C9: 82u; CP_Elec_5x5.8
D1: LED; LED_0603
J1: SH; JST_SH_BM06B-SRSS-TB_06x1.00mm_Straight
J2: SH; JST_SH_BM04B-SRSS-TB_04x1.00mm_Straight
J3: FFC; Molex_FFC_22
LCD1: AQM0802A
LED1: OSTB0603C1C-A
R1, R2, R3, R4, R5, R6: 10k; R_0603
R7: 1.2k; R_0603
R8: 680; R_0603
R9: 470; R_0603
R10, R11: 4.7k; R_0603
R12: 360; R_0603
SW1, SW2, SW3, SW6: SKRPACE010
SW4: SSSS213202
SW5: FR01SC16P-S; FR01SC16P

Connections:
+3V3: C5.2, C7.2, C8.1, C9.1, J1.1, J2.1, J3.22, LCD1.5, LED1.1, R1.1, R3.1, R5.1, R10.1, R11.1, R12.1
GND: C1.1, C2.1, C3.1, C4.2, C7.1, C8.2, C9.2, D1.1, J1.3, J2.4, J3.1, LCD1.6, SW1.2, SW2.2, SW3.2, SW4.3, SW5.C, SW6.2
I2C_SCL_LCD: J3.15, LCD1.8, R11.2
I2C_SDA_LCD: J3.16, LCD1.7, R10.2
LED2_B: J3.20, R9.1
LED2_G: J3.17, R8.1
LED2_R: J3.19, R7.1
NRST: C4.1, J1.5, J3.18, SW6.1
unnamed: C5.1, LCD1.2
unnamed: C6.1, LCD1.4
unnamed: C6.2, LCD1.3
unnamed: D1.2, R12.2
unnamed: LED1.2, R7.2
unnamed: LED1.3, R9.2
unnamed: LED1.4, R8.2
unnamed: R1.2, R2.2, SW1.1
unnamed: R3.2, R4.2, SW2.1
unnamed: R5.2, R6.2, SW3.1
POWER_SW: J3.21, SW4.2
R_SW1: J3.11, SW5.1
R_SW2: J3.10, SW5.2
R_SW4: J3.9, SW5.4
R_SW8: J3.8, SW5.8
SWCLK: J1.2, J3.7
SWDIO: J1.4, J3.6
SWO: J1.6, J3.5
T_SW1: C1.2, J3.14, R2.1
T_SW2: C2.2, J3.13, R4.1
T_SW3: C3.2, J3.12, R6.1
UART_RX: J2.2, J3.3
UART_TX: J2.3, J3.4
