shimotoriharuki/2019_RobotLancer_kicad/General_purpose_lancer_board/General_purpose_lancer_board.kicad_pcb

## KiCad design General_purpose_lancer_board/General_purpose_lancer_board.kicad_pcb (2021-03-22)

Schematic: General_purpose_lancer_board.sch, General-purpose Lancer board

Parts:
C1, C2, C3, C4, C5, C6, C7, C12, C13, C15: 0.1u; C_0603
C8: 330u; CP_Elec_8x6.7
C9, C11, C19: 47u; C_1210
C10, C14: 2.2u; C_0603
C16: 0.01u; C_0603
C17: 470p; C_0603
C18, C22: 100u; CP_Elec_5x5.8
C20: 1u; C_0603
C21: 10u; C_0603
D1, D7, D8: OSBL1608; LED_0603
D2: SS2040; D_SOD-123F
D3: 1SMB5930BT3G; D_SMB
D4: RSX101VAM; TUMD2M
D5: 1N4148; D_SOD-123
D6: 1SMB5920BT3G; D_SMB
FET13: SI7141DP; SO-8_PowerPAK_Vishay_Single
J1: SH; JST_SH_BM06B-SRSS-TB_06x1.00mm_Straight
J2: SH; JST_SH_BM04B-SRSS-TB_04x1.00mm_Straight
J3: XT30; XT30PW-M
L1: 330; L_0603
R1: 50k; R_0603
R2: 12k; R_0603
R3, R7: 10k; R_0603
R4: 6.8K; R_0603
R5: 15K; R_0603
R6: 30k; R_0603
R8: 1.8K; R_0603
R9: 390; R_0603
RV1: ST2TA101; ST2TA
SD25-220-R1: 22u; SD25-220-R
SW1: SKRPACE010
SW2: SSSS213202
U1: STM32F446VE; LQFP-100_14x14mm_Pitch0.5mm
U2: LT1933; TSOT-23-6
U3: NJM2884U1-33; SOT-89-5_Housing
X1: ECS-2520S; Crystal_SMD_EuroQuartz_X22-4pin_2.5x2.0mm_HandSoldering
X2: TC25L5I32K7680; Crystal_SMD_EuroQuartz_X22-4pin_2.5x2.0mm_HandSoldering

Connections:
+3V3: C1.1, C3.1, C4.2, C5.1, C6.2, C7.1, C12.1, C15.1, C21.1, C22.1, J1.1, J2.1, L1.2, R1.1, R9.1, U1.6, U1.11, U1.19, U1.28, U1.50, U1.75, U1.100, U3.4, X1.1, X1.4, X2.1, X2.4; also elsewhere on the board
+5V: C17.1, C18.1, C19.1, C20.1, D5.2, D6.1, R6.1, R8.1, U3.1, U3.5; also elsewhere on the board
+BATT: C8.1, C9.1, D2.2, FET13.5, FET13.6, FET13.7, FET13.8, R4.1; also elsewhere on the board
ADC_LINE1: U1.15; also elsewhere on the board
ADC_LINE2: U1.16; also elsewhere on the board
ADC_LINE3: U1.17; also elsewhere on the board
ADC_LINE4: U1.18; also elsewhere on the board
ADC_LINE5: U1.25; also elsewhere on the board
ADC_LINE6: U1.26; also elsewhere on the board
ADC_POT1: U1.29; also elsewhere on the board
ADC_POT2: U1.30; also elsewhere on the board
ADC_POT3: U1.33; also elsewhere on the board
C_SW1: U1.88; also elsewhere on the board
C_SW2: U1.91; also elsewhere on the board
C_SW3: U1.96; also elsewhere on the board
C_SW4: U1.87; also elsewhere on the board
C_SW5: U1.97; also elsewhere on the board
ENCORDER_A: U1.23; also elsewhere on the board
ENCORDER_B: U1.24; also elsewhere on the board
GND: C1.2, C2.2, C3.2, C4.1, C5.2, C6.1, C7.2, C8.2, C9.2, C10.2, C11.2, C12.2, C13.2, C14.1, C15.2, C18.2, C19.2, C20.2, C21.2, C22.2, D1.1, D3.2, D4.2, D6.2, D7.1, D8.1, J1.3, J2.4, J3.2, R3.1, R7.2, SW1.2, SW2.3, U1.10, U1.20, U1.27, U1.49, U1.74, U1.99, U2.2, U3.2, X1.2, X2.2; also elsewhere on the board
GPIO_DRIVE1_P: U1.37; also elsewhere on the board
GPIO_DRIVE1_SR: U1.34; also elsewhere on the board
GPIO_DRIVE2_P: U1.38; also elsewhere on the board
GPIO_DRIVE2_SR: U1.39; also elsewhere on the board
GPIO_DRIVE3_P: U1.57; also elsewhere on the board
GPIO_DRIVE3_SR: U1.58; also elsewhere on the board
GPIO_DRIVE4_P: U1.70; also elsewhere on the board
GPIO_DRIVE4_SR: U1.71; also elsewhere on the board
GPIO_SERVO1_SR: U1.41; also elsewhere on the board
GPIO_SERVO2_SR: U1.68; also elsewhere on the board
I2C_SCL_CURRENT: U1.92; also elsewhere on the board
I2C_SCL_LCD: U1.67; also elsewhere on the board
I2C_SDA_CURRENT: U1.93; also elsewhere on the board
I2C_SDA_LCD: U1.90; also elsewhere on the board
LED1_B: U1.46; also elsewhere on the board
LED1_G: U1.44; also elsewhere on the board
LED1_R: U1.43; also elsewhere on the board
LED2_B: U1.2; also elsewhere on the board
LED2_G: U1.98; also elsewhere on the board
LED2_R: U1.3; also elsewhere on the board
NRST: C2.1, J1.5, R1.2, SW1.1, U1.14; also elsewhere on the board
unnamed: C10.1, U1.48
unnamed: C11.1, D2.1, D3.1, R5.1, U2.5
unnamed: C13.1, R5.2, U2.4
unnamed: C14.2, U1.73
unnamed: C16.1, D5.1, U2.1
unnamed 57: C16.2, D4.1, U2.6; also elsewhere on the board
unnamed: C17.2, RV1.2, U2.3
unnamed: D1.2, R4.2
unnamed: D7.2, R8.2
unnamed: D8.2, R9.2
unnamed: FET13.1, FET13.2, FET13.3, J3.1, R2.1
unnamed: L1.1, U1.21, U1.22
unnamed: R3.2, U1.94
unnamed: R6.2, RV1.3
unnamed: R7.1, RV1.1
OSC32_IN: U1.8, X2.3
OSC_IN: U1.12, X1.3
POWER_SW: FET13.4, R2.2, SW2.2; also elsewhere on the board
PWM_BZ: U1.95; also elsewhere on the board
PWM_DRIVE1_H: U1.32; also elsewhere on the board
PWM_DRIVE1_L: U1.31; also elsewhere on the board
PWM_DRIVE2_H: U1.36; also elsewhere on the board
PWM_DRIVE2_L: U1.35; also elsewhere on the board
PWM_DRIVE3_H: U1.60; also elsewhere on the board
PWM_DRIVE3_L: U1.59; also elsewhere on the board
PWM_DRIVE4_H: U1.62; also elsewhere on the board
PWM_DRIVE4_L: U1.61; also elsewhere on the board
PWM_LINE_SENSOR: U1.53; also elsewhere on the board
PWM_SERVO1_H: U1.40; also elsewhere on the board
PWM_SERVO1_L: U1.42; also elsewhere on the board
PWM_SERVO1_P: U1.45; also elsewhere on the board
PWM_SERVO2_H: U1.64; also elsewhere on the board
PWM_SERVO2_L: U1.63; also elsewhere on the board
PWM_SERVO2_P: U1.69; also elsewhere on the board
REMAINDER_PD0: U1.81; also elsewhere on the board
REMAINDER_PD1: U1.82; also elsewhere on the board
R_SW1: U1.54; also elsewhere on the board
R_SW2: U1.52; also elsewhere on the board
R_SW4: U1.47; also elsewhere on the board
R_SW8: U1.51; also elsewhere on the board
SDIO_CK: U1.80; also elsewhere on the board
SDIO_CMD: U1.83; also elsewhere on the board
SDIO_D0: U1.65; also elsewhere on the board
SDIO_D1: U1.66; also elsewhere on the board
SDIO_D2: U1.78; also elsewhere on the board
SDIO_D3: U1.79; also elsewhere on the board
SD_INSERT: U1.77; also elsewhere on the board
SPI_CS_IMU: U1.7; also elsewhere on the board
SPI_MISO_IMU: U1.4; also elsewhere on the board
SPI_MOSI_IMU: U1.5; also elsewhere on the board
SPI_SCK_IMU: U1.1; also elsewhere on the board
SWCLK: J1.2, U1.76; also elsewhere on the board
SWDIO: J1.4, U1.72; also elsewhere on the board
SWO: J1.6, U1.89; also elsewhere on the board
T_SW1: U1.86; also elsewhere on the board
T_SW2: U1.85; also elsewhere on the board
T_SW3: U1.84; also elsewhere on the board
USART_RX: J2.2, U1.56; also elsewhere on the board
USART_TX: J2.3, U1.55; also elsewhere on the board

Notes on the sheet:
Power Supply
Crystals
Debugger
Reset
X2 does not need to be implemented
R1 does not need to be implemented

Schematic: motor_driver.sch, General-purpose Lancer board

Parts:
C23, C24, C25, C26, C27, C28, C29, C30, C31, C32, C33, C37, C59, C60, C63, C64: 0.1u; C_0603
C34, C35, C36, C38, C61, C62: 0.47u; C_0603
C39, C40, C41, C43, C44, C46, C47, C49, C50, C51, C53, C54, C65, C66, C68, C69, C71, C72: 0.22u; C_0603
C42, C45, C48, C52, C67, C70: 10u; C_0603
C55, C56, C57, C58, C73, C74: 47u; C_1210
C85, C86: 330u; CP_Elec_8x6.7
FET1, FET2, FET3, FET4, FET5, FET6, FET7, FET8, FET9, FET10, FET11, FET12: IRF8915
IC1, IC2, IC3, IC4, IC5, IC6: A3921; TSSOP-28-1EP_4.4x9.7mm_Pitch0.65mm
J4, J5, J6, J7, J8, J9: PA_SIDE; SM02B-PASS
R10, R11, R12, R13, R14, R15, R16, R17, R18, R19, R20, R21, R22, R23, R24, R25, R26, R27, R28, R29, R30, R31, R32, R33, R34, R35, R36, R37, R38, R39, R40, R41, R42, R46, R47, R48, R66, R67, R68, R69, R70, R71: 10K; R_0603
R43, R44, R45, R49, R72, R73: 5k; R_0603
R50, R51, R52, R53, R54, R55, R56, R57, R58, R59, R60, R61, R62, R63, R64, R65, R75, R76, R77, R78, R79, R80, R81, R82: 75; R_0603
R74, R83: 4.7k; R_0603
RN1, RN2, RN3, RN4, RN5, RN6: 10K; R_Array_Convex_4x0603
U4, U5, U6, U7: SI8660BA; SOIC-16_3.9x9.9mm_Pitch1.27mm
U8: INA260; TSSOP-16_4.4x5mm_Pitch0.65mm

Connections:
+3V3: C23.1, C24.1, C25.1, C26.1, C27.1, C28.1, C29.1, C30.1, C63.1, R34.1, R35.1, R36.1, R37.1, R38.1, R39.1, R40.1, R41.1, R42.1, R46.1, R47.1, R48.1, R66.1, R67.1, R68.1, R69.1, R70.1, R71.1, R74.1, R83.1, U4.1, U4.16, U5.1, U5.16, U6.1, U6.16, U7.1, U7.16, U8.4, U8.10; also elsewhere on the board
+BATT: C42.1, C45.1, C48.1, C52.1, C55.1, C56.1, C57.1, C58.1, C64.1, C67.1, C70.1, C73.1, C74.1, C85.1, C86.1, FET1.5, FET1.6, FET2.7, FET2.8, FET3.5, FET3.6, FET4.7, FET4.8, FET5.5, FET5.6, FET6.7, FET6.8, FET7.5, FET7.6, FET8.7, FET8.8, FET9.5, FET9.6, FET10.7, FET10.8, FET11.5, FET11.6, FET12.7, FET12.8, IC1.1, IC1.13, IC2.1, IC2.13, IC3.1, IC3.13, IC4.1, IC4.13, IC5.1, IC5.13, IC6.1, IC6.13, U8.12; also elsewhere on the board
GND: C23.2, C24.2, C25.2, C26.2, C27.2, C28.2, C29.2, C30.2, C31.2, C32.2, C33.2, C37.2, C39.2, C40.2, C41.2, C42.2, C45.2, C48.2, C51.2, C52.2, C55.2, C56.2, C57.2, C58.2, C59.2, C60.2, C63.2, C64.2, C65.2, C66.2, C67.2, C70.2, C73.2, C74.2, C85.2, C86.2, FET1.1, FET2.3, FET3.1, FET4.3, FET5.1, FET6.3, FET7.1, FET8.3, FET9.1, FET10.3, FET11.1, FET12.3, IC1.2, IC1.17, IC1.29, IC2.2, IC2.17, IC2.29, IC3.2, IC3.17, IC3.29, IC4.2, IC4.17, IC4.29, IC5.2, IC5.17, IC5.29, IC6.2, IC6.17, IC6.29, R10.2, R11.2, R12.2, R13.2, R14.2, R15.2, R16.2, R17.2, R18.2, R19.2, R20.2, R21.2, R22.2, R23.2, R24.2, R25.2, R26.2, R27.2, R28.2, R29.2, R30.2, R31.2, R32.2, R33.2, R43.2, R44.2, R45.2, R49.2, R72.2, R73.2, RN1.1, RN1.2, RN1.3, RN1.4, RN2.1, RN2.2, RN2.3, RN2.4, RN3.1, RN3.2, RN3.3, RN3.4, RN4.1, RN4.2, RN4.3, RN4.4, RN5.1, RN5.2, RN5.3, RN5.4, RN6.1, RN6.2, RN6.3, RN6.4, U4.8, U4.9, U5.8, U5.9, U6.8, U6.9, U7.8, U7.9, U8.5, U8.6, U8.7, U8.11; also elsewhere on the board
GPIO_DRIVE1_P: R15.1, U4.6; also elsewhere on the board
GPIO_DRIVE1_P_I: IC2.19, RN2.8, U4.11
GPIO_DRIVE1_SR: R11.1, U4.7; also elsewhere on the board
GPIO_DRIVE1_SR_I: IC2.21, RN2.7, U4.10
GPIO_DRIVE2_P: R25.1, U6.4; also elsewhere on the board
GPIO_DRIVE2_P_I: IC5.19, RN5.8, U6.13
GPIO_DRIVE2_SR: R21.1, U6.5; also elsewhere on the board
GPIO_DRIVE2_SR_I: IC5.21, RN5.7, U6.12
GPIO_DRIVE3_P: R20.1, U5.5; also elsewhere on the board
GPIO_DRIVE3_P_I: IC6.19, RN6.8, U5.12
GPIO_DRIVE3_SR: R24.1, U5.4; also elsewhere on the board
GPIO_DRIVE3_SR_I: IC6.21, RN6.7, U5.13
GPIO_DRIVE4_P: R30.1, U7.2; also elsewhere on the board
GPIO_DRIVE4_P_I: IC3.19, RN3.8, U7.15
GPIO_DRIVE4_SR: R26.1, U7.3; also elsewhere on the board
GPIO_DRIVE4_SR_I: IC3.21, RN3.7, U7.14
GPIO_SERVO1_SR: R27.1, U4.3; also elsewhere on the board
GPIO_SERVO1_SR_I: IC4.21, RN4.7, U4.14
GPIO_SERVO2_SR: R12.1, U5.7; also elsewhere on the board
GPIO_SERVO2_SR_I: IC1.21, RN1.7, U5.10
I2C_SCL_CURRENT: R83.2, U8.9; also elsewhere on the board
I2C_SDA_CURRENT: R74.2, U8.8; also elsewhere on the board
unnamed: C31.1, IC1.20, IC1.28
unnamed: C32.1, IC2.20, IC2.28
unnamed: C33.1, IC3.20, IC3.28
unnamed: C34.1, IC1.16
unnamed: C34.2, IC1.15
unnamed: C35.1, IC2.16
unnamed: C35.2, IC2.15
unnamed: C36.1, IC3.16
unnamed: C36.2, IC3.15
unnamed: C37.1, IC4.20, IC4.28
unnamed: C38.1, IC4.16
unnamed: C38.2, IC4.15
unnamed: C39.1, IC1.8
unnamed: C40.1, IC2.8
unnamed: C41.1, IC3.8
unnamed: C43.1, IC1.9
unnamed: C43.2, FET1.3, FET1.7, FET1.8, IC1.11, J4.1
unnamed: C44.1, IC1.6
unnamed: C44.2, FET2.1, FET2.5, FET2.6, IC1.4, J4.2
unnamed: C46.1, IC2.9
unnamed: C46.2, FET3.3, FET3.7, FET3.8, IC2.11, J5.1
unnamed: C47.1, IC2.6
unnamed: C47.2, FET4.1, FET4.5, FET4.6, IC2.4, J5.2
unnamed: C49.1, IC3.9
unnamed: C49.2, FET5.3, FET5.7, FET5.8, IC3.11, J6.1
unnamed: C50.1, IC3.6
unnamed: C50.2, FET6.1, FET6.5, FET6.6, IC3.4, J6.2
unnamed: C51.1, IC4.8
unnamed: C53.1, IC4.9
unnamed: C53.2, FET7.3, FET7.7, FET7.8, IC4.11, U8.1, U8.2, U8.3
unnamed: C54.1, IC4.6
unnamed: C54.2, FET8.1, FET8.5, FET8.6, IC4.4, J7.1
unnamed: C59.1, IC5.20, IC5.28
unnamed: C60.1, IC6.20, IC6.28
unnamed: C61.1, IC5.16
unnamed: C61.2, IC5.15
unnamed: C62.1, IC6.16
unnamed: C62.2, IC6.15
unnamed: C65.1, IC5.8
unnamed: C66.1, IC6.8
unnamed: C68.1, IC5.9
unnamed: C68.2, FET9.3, FET9.7, FET9.8, IC5.11, J8.1
unnamed: C69.1, IC5.6
unnamed: C69.2, FET10.1, FET10.5, FET10.6, IC5.4, J8.2
unnamed: C71.1, IC6.9
unnamed: C71.2, FET11.3, FET11.7, FET11.8, IC6.11, J9.1
unnamed: C72.1, IC6.6
unnamed: C72.2, FET12.1, FET12.5, FET12.6, IC6.4, J9.2
unnamed: FET1.2, R50.2
unnamed: FET1.4, R51.2
unnamed: FET2.2, R52.2
unnamed: FET2.4, R53.2
unnamed: FET3.2, R54.2
unnamed: FET3.4, R55.2
unnamed: FET4.2, R56.2
unnamed: FET4.4, R57.2
unnamed: FET5.2, R58.2
unnamed: FET5.4, R59.2
unnamed: FET6.2, R60.2
unnamed: FET6.4, R61.2
unnamed: FET7.2, R62.2
unnamed: FET7.4, R63.2
unnamed: FET8.2, R64.2
unnamed: FET8.4, R65.2
unnamed: FET9.2, R75.2
unnamed: FET9.4, R76.2
unnamed: FET10.2, R77.2
unnamed: FET10.4, R78.2
unnamed: FET11.2, R79.2
unnamed: FET11.4, R80.2
unnamed: FET12.2, R81.2
unnamed: FET12.4, R82.2
unnamed: IC1.3, R53.1
unnamed: IC1.5, R52.1
unnamed: IC1.10, R51.1
unnamed: IC1.12, R50.1
unnamed: IC1.24, R40.2
unnamed: IC1.25, R37.2
unnamed: IC1.26, R34.2
unnamed: IC1.27, R43.1
unnamed: IC2.3, R57.1
unnamed: IC2.5, R56.1
unnamed: IC2.10, R55.1
unnamed: IC2.12, R54.1
unnamed: IC2.24, R41.2
unnamed: IC2.25, R38.2
unnamed: IC2.26, R35.2
unnamed: IC2.27, R44.1
unnamed: IC3.3, R61.1
unnamed: IC3.5, R60.1
unnamed: IC3.10, R59.1
unnamed: IC3.12, R58.1
unnamed: IC3.24, R42.2
unnamed: IC3.25, R39.2
unnamed: IC3.26, R36.2
unnamed: IC3.27, R45.1
unnamed: IC4.3, R65.1
unnamed: IC4.5, R64.1
unnamed: IC4.10, R63.1
unnamed: IC4.12, R62.1
unnamed: IC4.24, R48.2
unnamed: IC4.25, R47.2
unnamed: IC4.26, R46.2
unnamed: IC4.27, R49.1
unnamed: IC5.3, R78.1
unnamed: IC5.5, R77.1
unnamed: IC5.10, R76.1
unnamed: IC5.12, R75.1
unnamed: IC5.24, R70.2
unnamed: IC5.25, R68.2
unnamed: IC5.26, R66.2
unnamed: IC5.27, R72.1
unnamed: IC6.3, R82.1
unnamed: IC6.5, R81.1
unnamed: IC6.10, R80.1
unnamed: IC6.12, R79.1
unnamed: IC6.24, R71.2
unnamed: IC6.25, R69.2
unnamed: IC6.26, R67.2
unnamed: IC6.27, R73.1
unnamed: J7.2, U8.14, U8.15, U8.16
PWM_DRIVE1_H: R29.1, U6.3; also elsewhere on the board
PWM_DRIVE1_H_I: IC2.23, RN2.5, U6.14
PWM_DRIVE1_L: R33.1, U6.2; also elsewhere on the board
PWM_DRIVE1_L_I: IC2.22, RN2.6, U6.15
PWM_DRIVE2_H: R13.1, U6.7; also elsewhere on the board
PWM_DRIVE2_H_I: IC5.23, RN5.5, U6.10
PWM_DRIVE2_L: R17.1, U6.6; also elsewhere on the board
PWM_DRIVE2_L_I: IC5.22, RN5.6, U6.11
PWM_DRIVE3_H: R32.1, U5.2; also elsewhere on the board
PWM_DRIVE3_H_I: IC6.23, RN6.5, U5.15
PWM_DRIVE3_L: R28.1, U5.3; also elsewhere on the board
PWM_DRIVE3_L_I: IC6.22, RN6.6, U5.14
PWM_DRIVE4_H: R18.1, U7.5; also elsewhere on the board
PWM_DRIVE4_H_I: IC3.23, RN3.5, U7.12
PWM_DRIVE4_L: R22.1, U7.4; also elsewhere on the board
PWM_DRIVE4_L_I: IC3.22, RN3.6, U7.13
PWM_SERVO1_H: R19.1, U4.5; also elsewhere on the board
PWM_SERVO1_H_I: IC4.23, RN4.5, U4.12
PWM_SERVO1_L: R23.1, U4.4; also elsewhere on the board
PWM_SERVO1_L_I: IC4.22, RN4.6, U4.13
PWM_SERVO1_P: R31.1, U4.2; also elsewhere on the board
PWM_SERVO1_P_I: IC4.19, RN4.8, U4.15
PWM_SERVO2_H: R10.1, U7.7; also elsewhere on the board
PWM_SERVO2_H_I: IC1.23, RN1.5, U7.10
PWM_SERVO2_L: R14.1, U7.6; also elsewhere on the board
PWM_SERVO2_L_I: IC1.22, RN1.6, U7.11
PWM_SERVO2_P: R16.1, U5.6; also elsewhere on the board
PWM_SERVO2_P_I: IC1.19, RN1.8, U5.11

Schematic: various.sch, General-purpose Lancer board

Parts:
BZ1: PKMCS0909E4000-R1; Buzzer_Murata_PKMCS0909E4000-R1
C75, C76, C77, C78, C79, C80, C81, C82: 0.1u; C_0603
C83: 47u; C_1210
C84: 10u; C_0603
J10: SH; JST_SH_BM04B-SRSS-TB_04x1.00mm_Straight
J11, J12, J14: SH; JST_SH_BM03B-SRSS-TB_03x1.00mm_Straight
J13: Micro_SD_Card_Det_Hirose_DM3AT; Hirose_DM3AT-SF-PEJM5
J15: SH; JST_SH_BM05B-SRSS-TB_05x1.00mm_Straight
J16: FFC; Molex_FFC_10
J17: FFC; Molex_FFC_22
L3, L4, L5, L6, L7, L8: 120; L_0603
LED1: OSTB0603C1C-A
Q2: IRLML6344; SOT-23
Q3: BSS138; SOT-23
R84: 1.2k; R_0603
R85: 680; R_0603
R86: 470; R_0603
R87, R88, R89, R90, R91, R92, R93, R94, R95, R96, R98, R99, R107: 10k; R_0603
R97: 0; R_0603
R100, R101, R102, R103, R104, R105, R106: 22k; R_0603
R108: 1k; R_0603
R109, R110, R112, R113, R115, R116: R; R_0603
R111, R117: 45; R_0603
R114: 47k; R_0603
RN7: 4.7k; R_Array_Convex_4x0603
U9: ICM20648
U10: JS1300AQ; JS1300

Connections:
+3V3: C76.1, C78.2, C83.1, C84.1, J11.1, J12.1, J13.4 (VDD), J14.1, J15.1, J16.1, J17.1, LED1.1, R88.1, R89.1, R90.1, R91.1, R92.1, R100.1, R101.1, R102.1, R104.1, R105.1, R106.1, R109.1, R110.1, R112.1, R113.1, R115.1, R116.1, RN7.5, RN7.6, RN7.7, RN7.8, U9.8, U9.13; also elsewhere on the board
+5V: BZ1.1, J10.1, J15.2, R98.1, R99.1, R108.2; also elsewhere on the board
ADC_LINE1: J16.7, R109.2; also elsewhere on the board
ADC_LINE2: J16.6, R110.2; also elsewhere on the board
ADC_LINE3: J16.5, R112.2; also elsewhere on the board
ADC_LINE4: J16.4, R113.2; also elsewhere on the board
ADC_LINE5: J16.3, R115.2; also elsewhere on the board
ADC_LINE6: J16.2, R116.2; also elsewhere on the board
ADC_POT1: J11.2; also elsewhere on the board
ADC_POT2: J12.2; also elsewhere on the board
ADC_POT3: J14.2; also elsewhere on the board
C_SW1: C82.1, R93.1; also elsewhere on the board
C_SW2: C81.1, R94.1; also elsewhere on the board
C_SW3: C80.1, R95.1; also elsewhere on the board
C_SW4: C79.1, R96.1; also elsewhere on the board
C_SW5: C75.1, R87.2; also elsewhere on the board
ENCORDER_A: J10.2, R98.2; also elsewhere on the board
ENCORDER_B: J10.3, R99.2; also elsewhere on the board
GND: C75.2, C76.2, C77.1, C78.1, C79.2, C80.2, C81.2, C82.2, C83.2, C84.2, J10.4, J11.3, J12.3, J13.6 (VSS), J13.9 (DET_B), J13.11 (SHIELD), J14.3, J15.5, J16.10, J17.22, Q2.2, Q3.2, R103.2, R107.2, R114.2, U9.17, U9.18, U9.20, U10.1, U10.3, U10.4, U10.5, U10.7; also elsewhere on the board
I2C_SCL_LCD: J17.8; also elsewhere on the board
I2C_SDA_LCD: J17.7; also elsewhere on the board
LED1_B: R86.1; also elsewhere on the board
LED1_G: R85.1; also elsewhere on the board
LED1_R: R84.1; also elsewhere on the board
LED2_B: J17.3; also elsewhere on the board
LED2_G: J17.6; also elsewhere on the board
LED2_R: J17.4; also elsewhere on the board
NRST: J17.5; also elsewhere on the board
unnamed: BZ1.2, Q3.3, R108.1
unnamed: C77.2, U9.10
unnamed: J13.1 (DAT2), L3.1, R100.2
unnamed: J13.2 (DAT3/CD), L4.1, R101.2
unnamed: J13.3 (CMD), L5.1, R102.2
unnamed: J13.5 (CLK), L6.1, R103.1
unnamed: J13.7 (DAT0), L7.1, R104.2
unnamed: J13.8 (DAT1), L8.1, R105.2
unnamed: J16.9, Q2.3
unnamed: L6.2, R97.1
unnamed: LED1.2, R84.2
unnamed: LED1.3, R86.2
unnamed: LED1.4, R85.2
unnamed: Q2.1, R111.1, R114.1
unnamed: Q3.1, R107.1, R117.1
unnamed: R87.1, R88.2, U10.2
unnamed: R89.2, R95.2, U10.10
unnamed: R90.2, R94.2, U10.9
unnamed: R91.2, R93.2, U10.8
unnamed: R92.2, R96.2, U10.6
POWER_SW: J17.2; also elsewhere on the board
PWM_BZ: R117.2; also elsewhere on the board
PWM_LINE_SENSOR: R111.2; also elsewhere on the board
REMAINDER_PD0: J15.4; also elsewhere on the board
REMAINDER_PD1: J15.3; also elsewhere on the board
R_SW1: J17.12; also elsewhere on the board
R_SW2: J17.13; also elsewhere on the board
R_SW4: J17.14; also elsewhere on the board
R_SW8: J17.15; also elsewhere on the board
SDIO_CK: R97.2; also elsewhere on the board
SDIO_CMD: L5.2; also elsewhere on the board
SDIO_D0: L7.2; also elsewhere on the board
SDIO_D1: L8.2; also elsewhere on the board
SDIO_D2: L3.2; also elsewhere on the board
SDIO_D3: L4.2; also elsewhere on the board
SD_INSERT: J13.10 (DET_A), R106.2; also elsewhere on the board
SPI_CS_IMU: RN7.1, U9.22; also elsewhere on the board
SPI_MISO_IMU: RN7.3, U9.9; also elsewhere on the board
SPI_MOSI_IMU: RN7.2, U9.24; also elsewhere on the board
SPI_SCK_IMU: RN7.4, U9.23; also elsewhere on the board
SWCLK: J17.16; also elsewhere on the board
SWDIO: J17.17; also elsewhere on the board
SWO: J17.18; also elsewhere on the board
T_SW1: J17.9; also elsewhere on the board
T_SW2: J17.10; also elsewhere on the board
T_SW3: J17.11; also elsewhere on the board
USART_RX: J17.20; also elsewhere on the board
USART_TX: J17.19; also elsewhere on the board

Notes on the sheet:
microSD
LED
Cross switch
Encoder
Potentio
IMU
Line Sensor
Remainder
C83 does not need to be implemented
R100 to R106 choose your own value

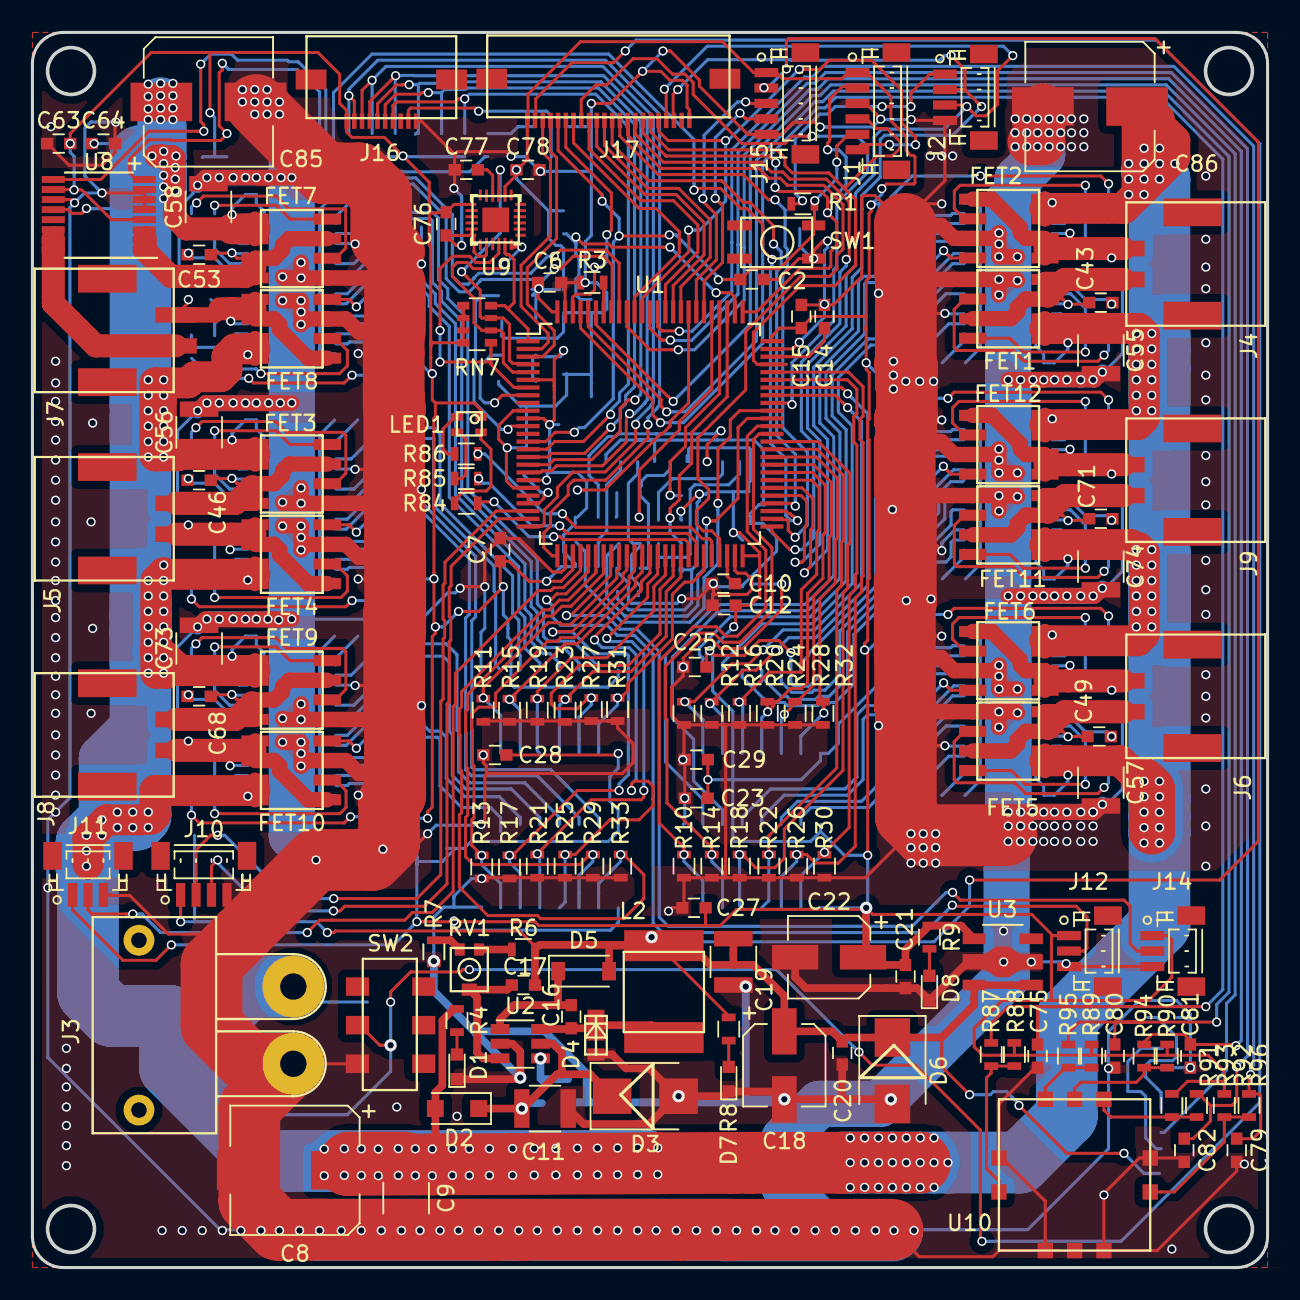
[picture p25: board General_purpose_lancer_board.kicad_pcb from above]

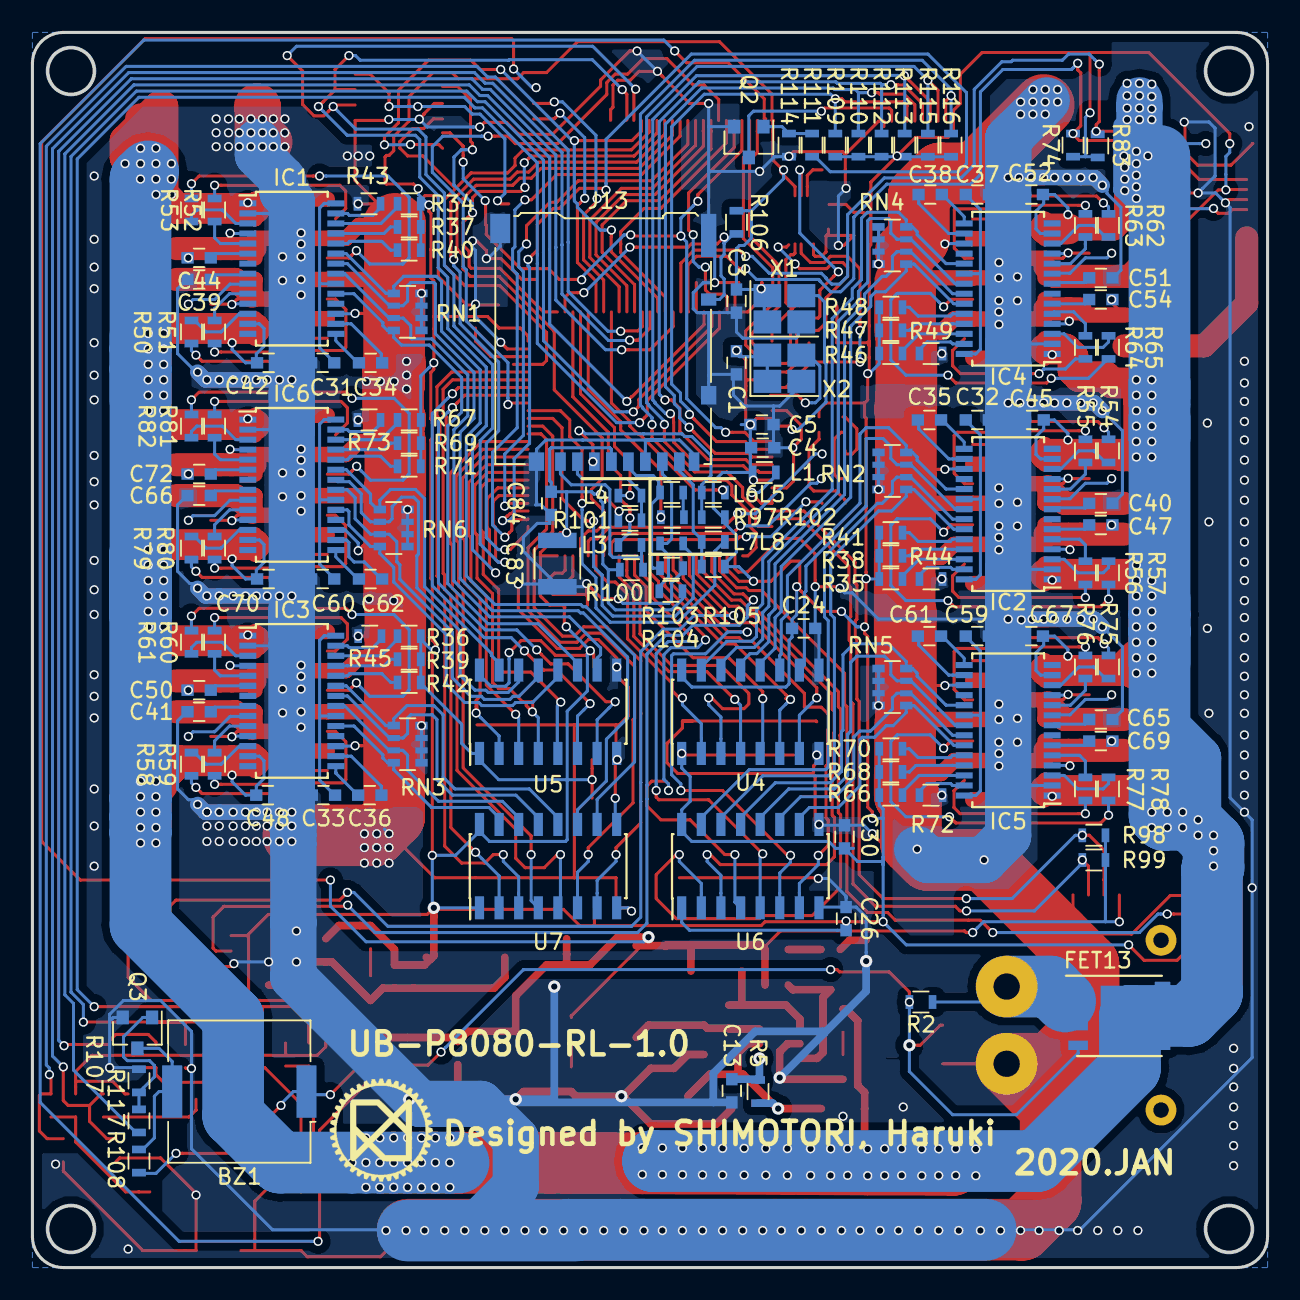
[picture p26: board General_purpose_lancer_board.kicad_pcb from below]

Board: 2 copper layers, 80.0 x 80.0 mm, 281 parts (143 on the bottom side), 265 nets.

Other parts of the board:
L2: 22u; SD25-220-R

Their connections:
+5V: L2.1; also elsewhere on the board
unnamed 57: L2.2; also elsewhere on the board
