shimotoriharuki/2019_RobotLancer_kicad/General_purpose_lancer_sensor_board/General_purpose_lancer_sensor_board/General_purpose_lancer_sensor_board.kicad_pcb

## KiCad design General_purpose_lancer_sensor_board/General_purpose_lancer_sensor_board/General_purpose_lancer_sensor_board.kicad_pcb (2021-03-22)

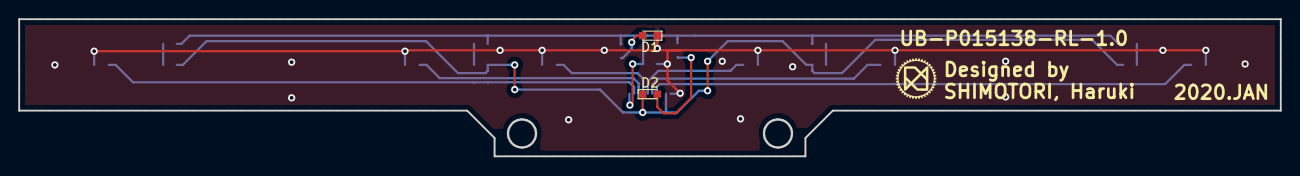
[picture p27: board General_purpose_lancer_sensor_board.kicad_pcb from above]

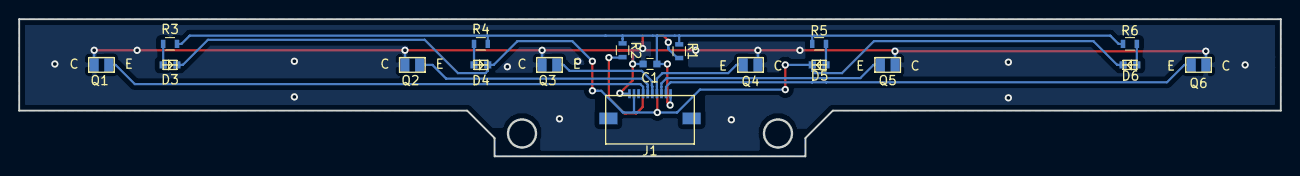
[picture p28: board General_purpose_lancer_sensor_board.kicad_pcb from below]

Board: 2 copper layers, 138.0 x 15.0 mm, 20 parts (18 on the bottom side), 15 nets.

Parts:
C1: 1u; C_0603
D1, D2: LED; LED_0603
D3, D4, D5, D6: SIR19-21C
J1: FFC; Molex_FFC_10
Q1, Q2, Q3, Q4, Q5, Q6: TEMT7100X01
R1, R2: 330; R_0603
R3, R4, R5, R6: 100; R_0603

Connections:
+3V3: C1.1, J1.1, R1.1, R2.1, R3.1, R4.1, R5.1, R6.1
ADC_LINE1: J1.7, Q1.1
ADC_LINE2: J1.6, Q2.1
ADC_LINE3: J1.5, Q3.1
ADC_LINE4: J1.4, Q4.1
ADC_LINE5: J1.3, Q5.1
ADC_LINE6: J1.2, Q6.1
GND: C1.2, D1.1, J1.10, Q1.2, Q2.2, Q3.2, Q4.2, Q5.2, Q6.2
unnamed: D1.2, R1.2
unnamed: D2.2, R2.2
unnamed: D3.2, R3.2
unnamed: D4.2, R4.2
unnamed: D5.2, R5.2
unnamed: D6.2, R6.2
PULS: D2.1, D3.1, D4.1, D5.1, D6.1, J1.9
